sperly/pbrain/hardware/enclosure/preview/back-open.png

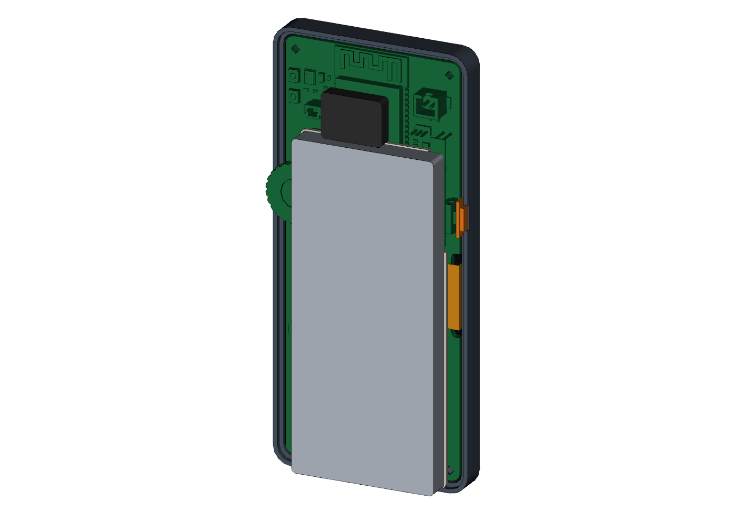
hardware/enclosure/preview/back-open.png
