sperly/pbrain/hardware/enclosure/preview/back.png

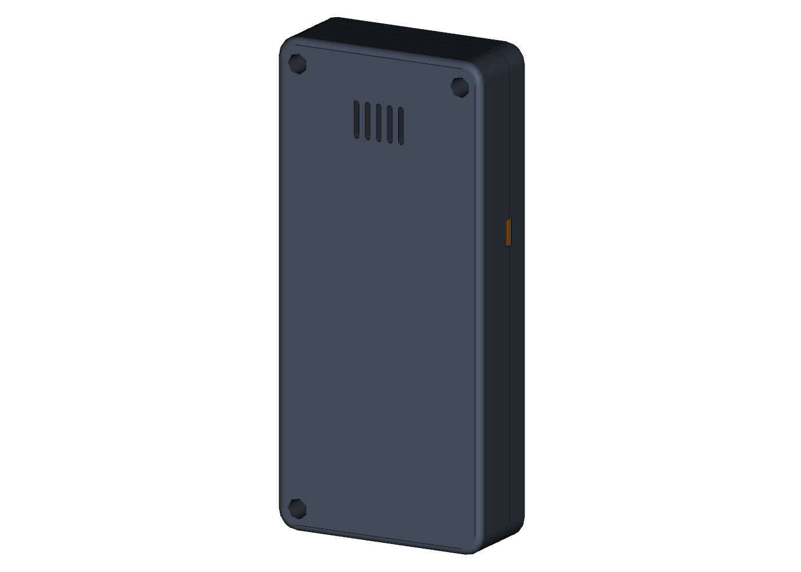
hardware/enclosure/preview/back.png
