sperly/pbrain/hardware/enclosure/preview/exploded.png

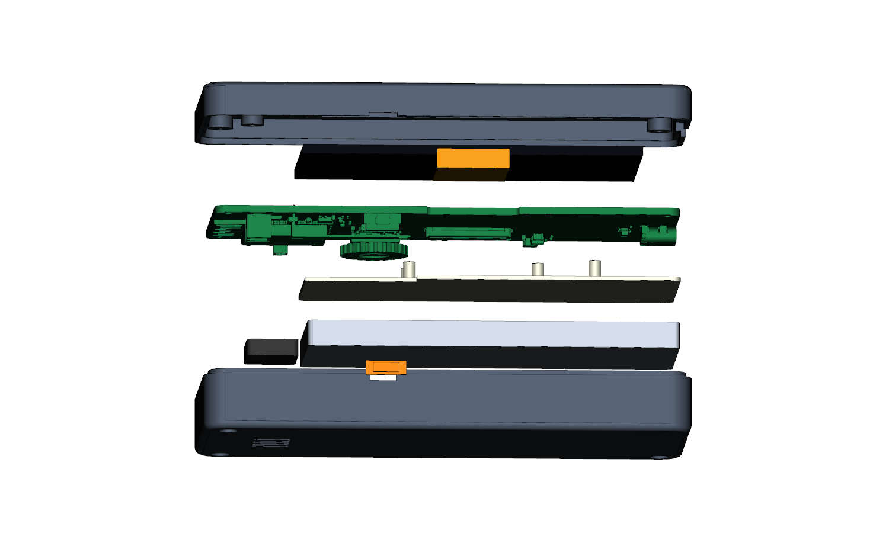
hardware/enclosure/preview/exploded.png
