sperly/pbrain/hardware/enclosure/pocketbrain-assembly.step

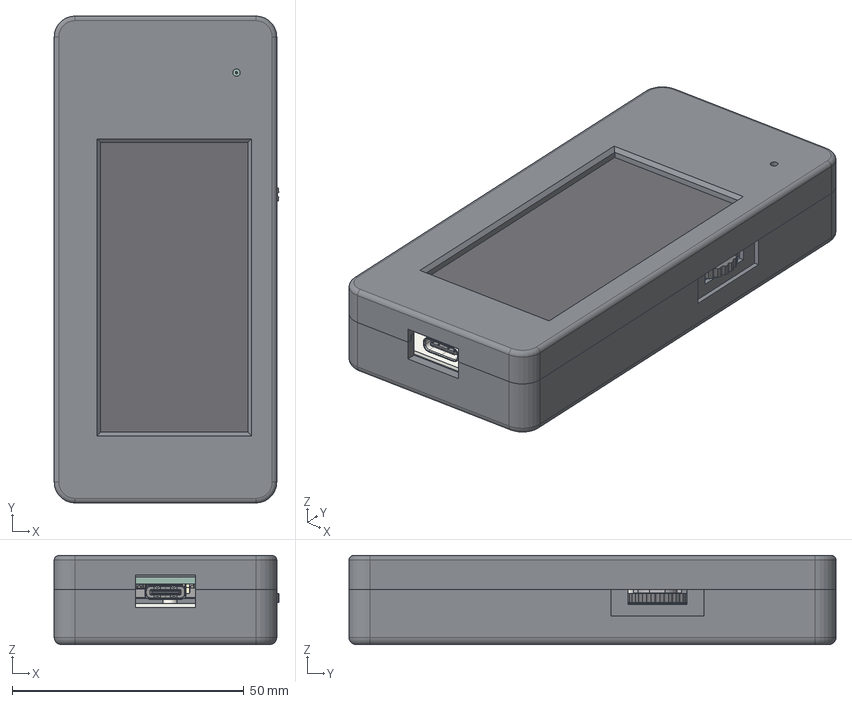
[picture p4: CAD file, 2026-11-11]
hardware/enclosure/pocketbrain-assembly.step
48.4 x 105.0 x 19.2 mm
C_0402_1005Metric x 12
C_0603_1608Metric x 7
Knowles_SPH0645LM4H-6_3.5x2.65mm
R_0402_1005Metric x 24
pads x 3
SW_SPST_B3U-1000P x 2
USB_C_Receptacle_16P_TopMnt_Horizontal_GCT_USB4105-xx-A
housing
pin0
tail0
pin1
tail1
tab0
tab1
ESP32-S3-WROOM-1
C_0805_2012Metric x 6
D_SOD-323 x 2
SOT-23-6 x 2
base
dial
hub
boss0
boss1
term0 x 2
term1 x 2
term2
term3
cover
actuator
leg0
peg0
leg1
peg1
core x 2
t0 x 2
t1 x 2
LED_0603_1608Metric
PinHeader_1x03_P127mm_Vertical
lead0
lead1
film
sensor
JST_SH_BM02B-SRSS-TB_1x02-1MP_P1.00mm_Vertical
lock
pins
pocketbrain_PCB
front_shell
back_shell
battery_tray
talk_button
oled_glass
oled_flex
battery
speaker
