sperly/pbrain/hardware/enclosure/battery_tray.step

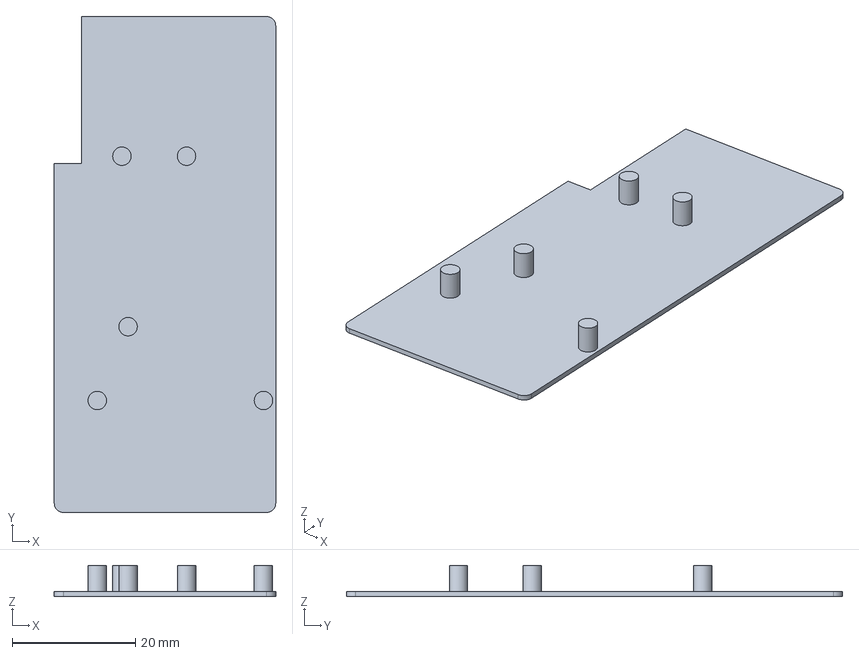
[picture p5: CAD file, 2026-11-11]
hardware/enclosure/battery_tray.step
36.0 x 80.6 x 5.05 mm
