sperly/pbrain/resources/pocketbrain-emboss-18mm.stl

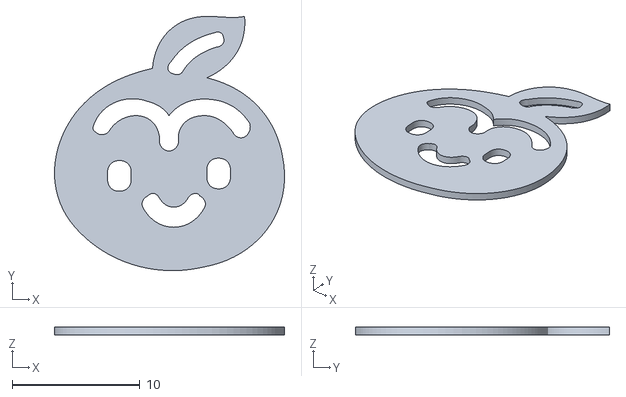
[picture p6: CAD file, 2026-11-11]
resources/pocketbrain-emboss-18mm.stl
18.0 x 19.9 x 0.6
