sperly/pbrain/hardware/enclosure/back_shell.step

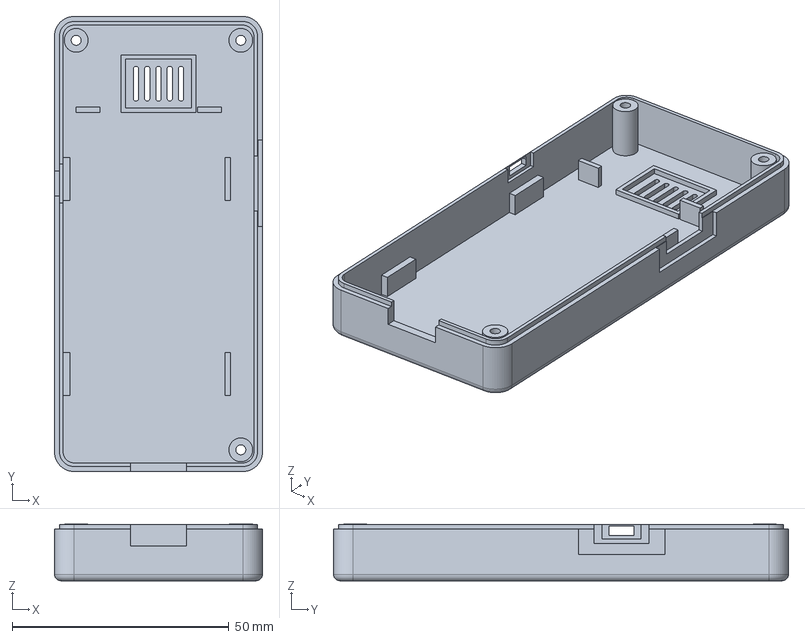
[picture p7: CAD file, 2026-11-11]
hardware/enclosure/back_shell.step
48.0 x 105.0 x 13.0 mm
