sperly/pbrain/hardware/enclosure/front_shell.step

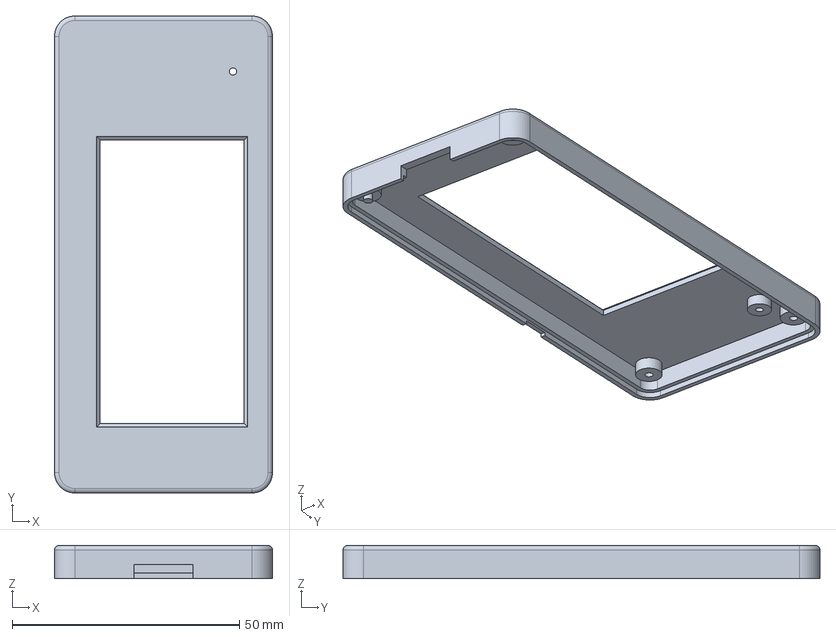
[picture p8: CAD file, 2026-11-11]
hardware/enclosure/front_shell.step
48.0 x 105.0 x 7.30 mm
