sperly/pbrain/hardware/enclosure/talk_button.step

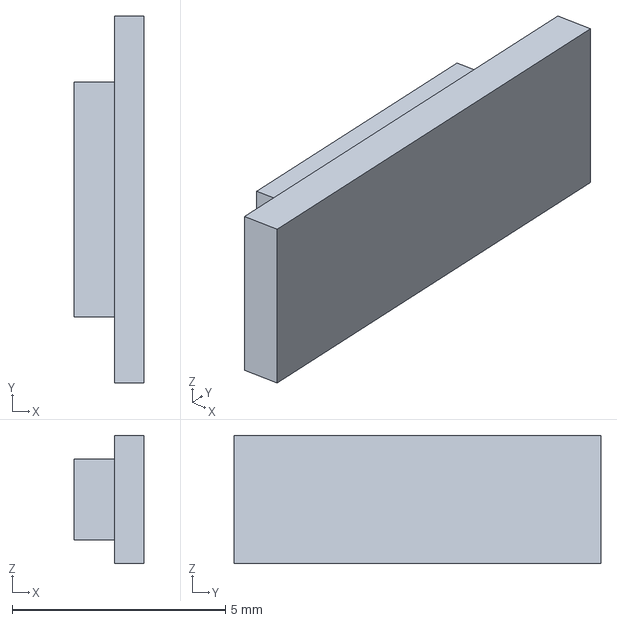
[picture p9: CAD file, 2026-11-11]
hardware/enclosure/talk_button.step
1.65 x 8.60 x 3.00 mm
