sperly/pbrain/(list of files, cad)

Other CAD files:
hardware/enclosure/back_shell.stl
hardware/enclosure/battery_tray.stl
hardware/enclosure/front_shell.stl
hardware/enclosure/talk_button.stl
