sperly/pbrain/hardware/pocketbrain-schematic.pdf

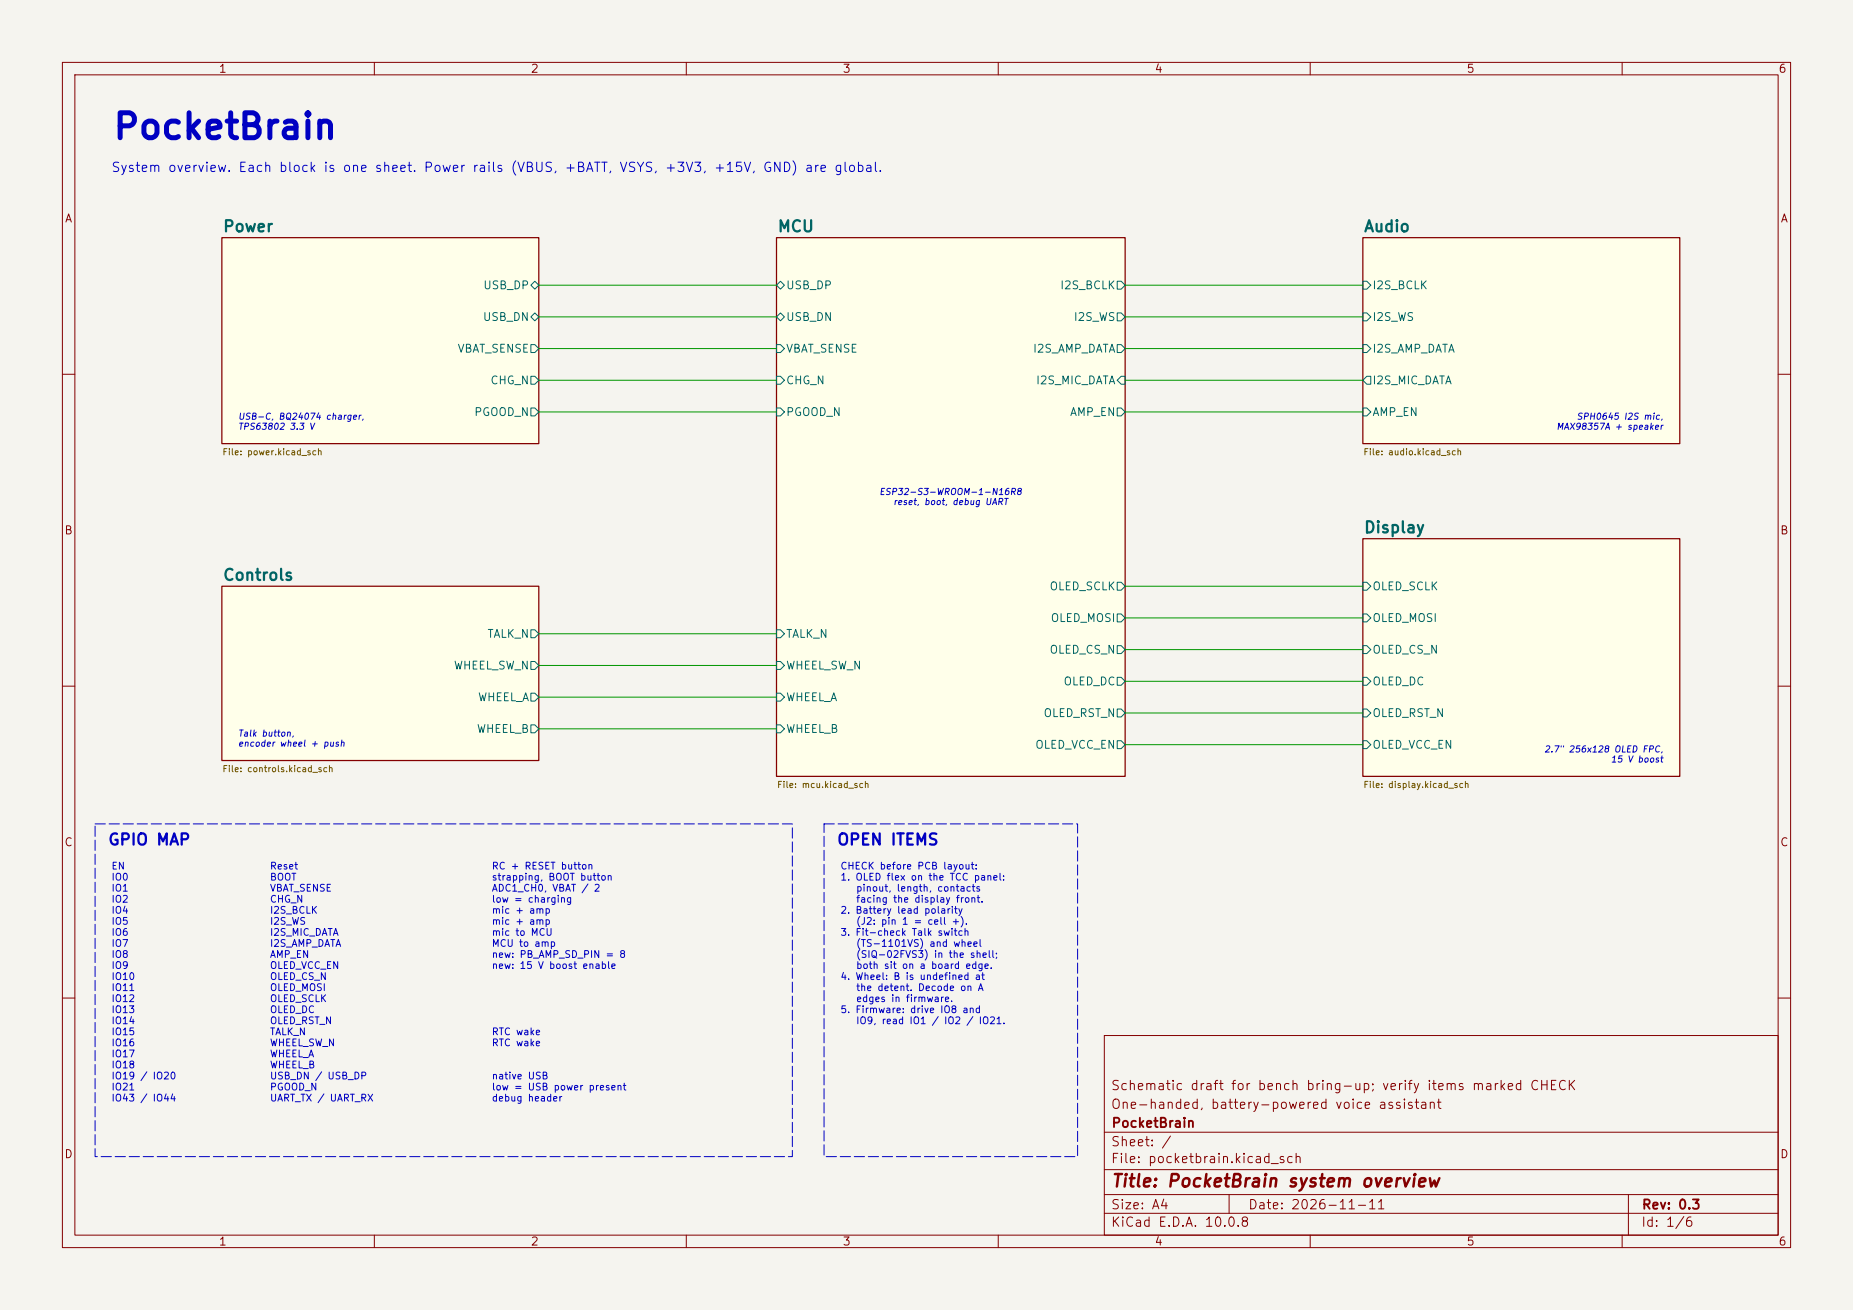
[picture p10: page 1]

System overview. Each block is one sheet. Power rails (VBUS, +BATT, VSYS, +3V3, +15V, GND) are global. USB-C, BQ24074 charger, TPS63802 3.3 V GPIO MAP

ESP32-S3-WROOM-1-N16R8
reset, boot, debug UART

Talk button, encoder wheel + push Reset BOOT VBAT_SENSE CHG_N

2.7" 256x128 OLED FPC, 15 V boost CHECK before PCB layout: 1. OLED flex on the TCC panel:

strapping, BOOT button
ADC1_CH0, VBAT / 2
low = charging mic + amp mic + amp mic to MCU MCU to amp

pinout, length, contacts
facing the display front. 2. Battery lead polarity

(J2: pin 1 = cell +). 3. Fit-check Talk switch

(TS-1101VS) and wheel (SIQ-02FVS3) in the shell; both sit on a board edge. 4. Wheel: B is undefined at

new: PB_AMP_SD_PIN = 8
new: 15 V boost enable RTC wake RTC wake native USB

the detent. Decode on A
edges in firmware. 5. Firmware: drive IO8 and

low = USB power present

Schematic draft for bench bring-up; verify items marked CHECK
One-handed, battery-powered voice assistant
PocketBrain
Sheet: /
File: pocketbrain.kicad_sch
Title: PocketBrain system overview

Size: A4 | Rev: 0.3
KiCad E.D.A. 10.0.8 | Id: 1/6

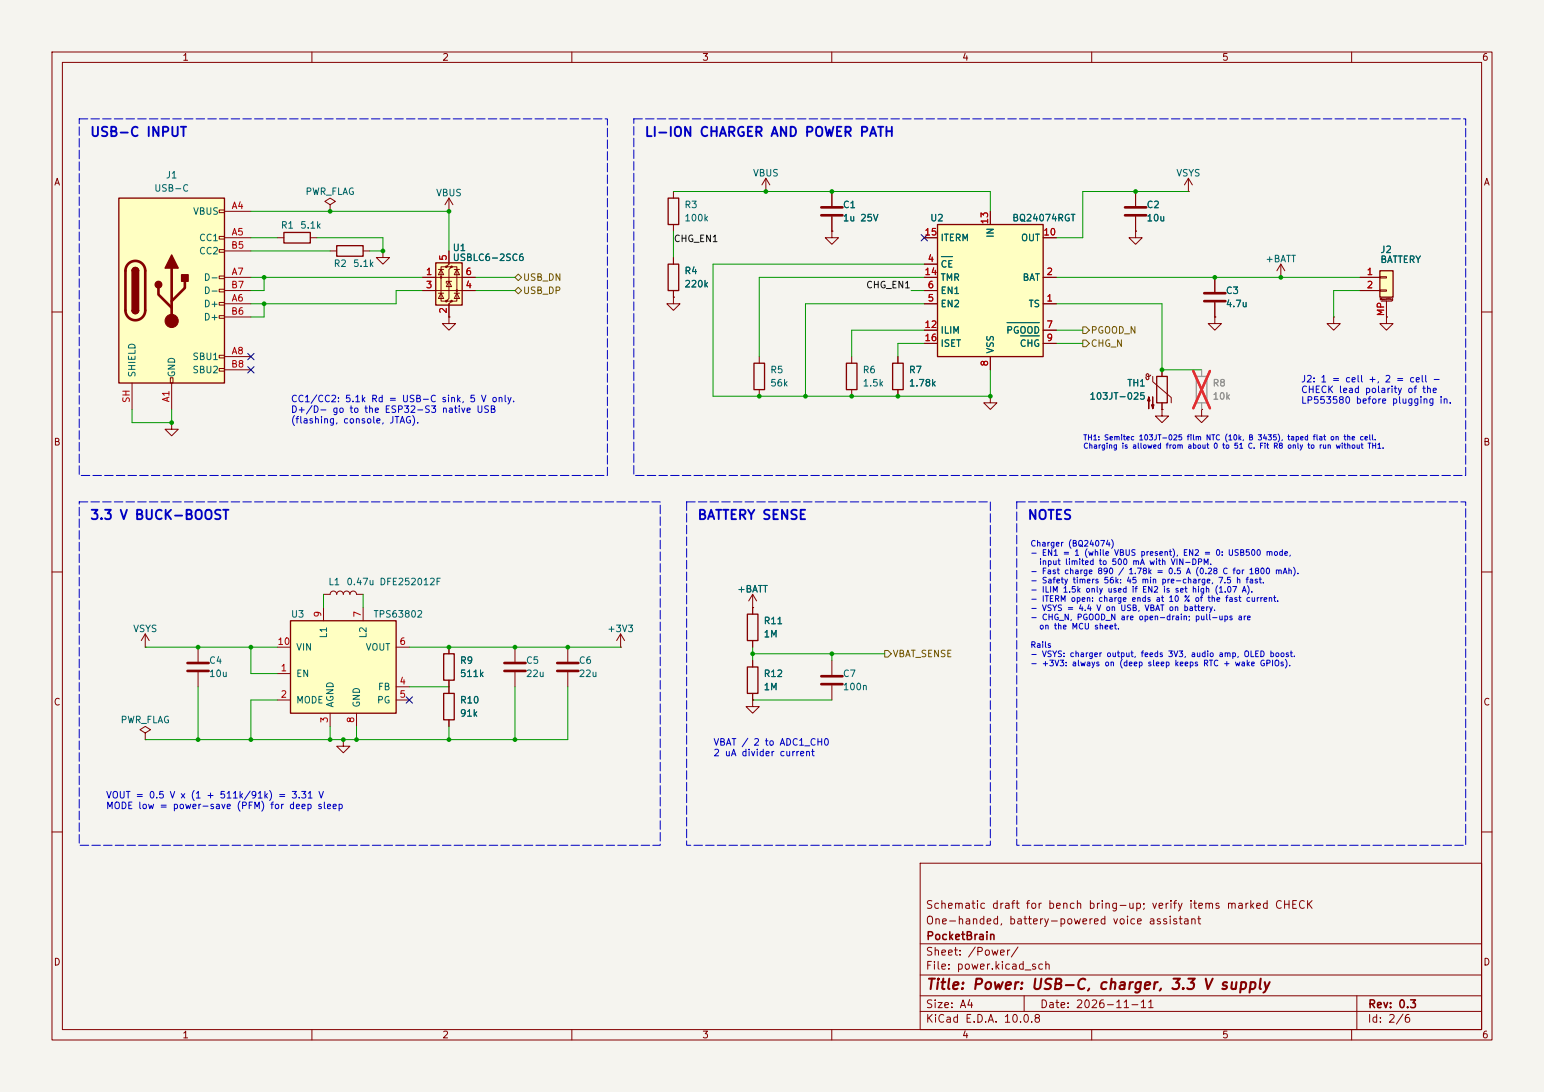
[picture p11: page 2]

J2: 1 = cell +, 2 = cell -
CHECK lead polarity of the

CC1/CC2: 5.1k Rd = USB-C sink, 5 V only.
D+/D- go to the ESP32-S3 native USB
(flashing, console, JTAG).

LP553580 before plugging in. TH1: Semitec 103JT-025 film NTC (10k, B 3435), taped flat on the cell. Charging is allowed from about 0 to 51 C. Fit R8 only to run without TH1. Charger (BQ24074) - EN1 = 1 (while VBUS present), EN2 = 0: USB500 mode,

input limited to 500 mA with VIN-DPM. - Fast charge 890 / 1.78k = 0.5 A (0.28 C for 1800 mAh). - Safety timers 56k: 45 min pre-charge, 7.5 h fast. - ILIM 1.5k only used if EN2 is set high (1.07 A). - ITERM open: charge ends at 10 % of the fast current. - VSYS = 4.4 V on USB, VBAT on battery. - CHG_N, PGOOD_N are open-drain; pull-ups are on the MCU sheet. Rails - VSYS: charger output, feeds 3V3, audio amp, OLED boost. - +3V3: always on (deep sleep keeps RTC + wake GPIOs). VOUT = 0.5 V x (1 + 511k/91k) = 3.31 V MODE low = power-save (PFM) for deep sleep

Schematic draft for bench bring-up; verify items marked CHECK
One-handed, battery-powered voice assistant
PocketBrain
Sheet: /Power/
File: power.kicad_sch
Title: Power: USB-C, charger, 3.3 V supply

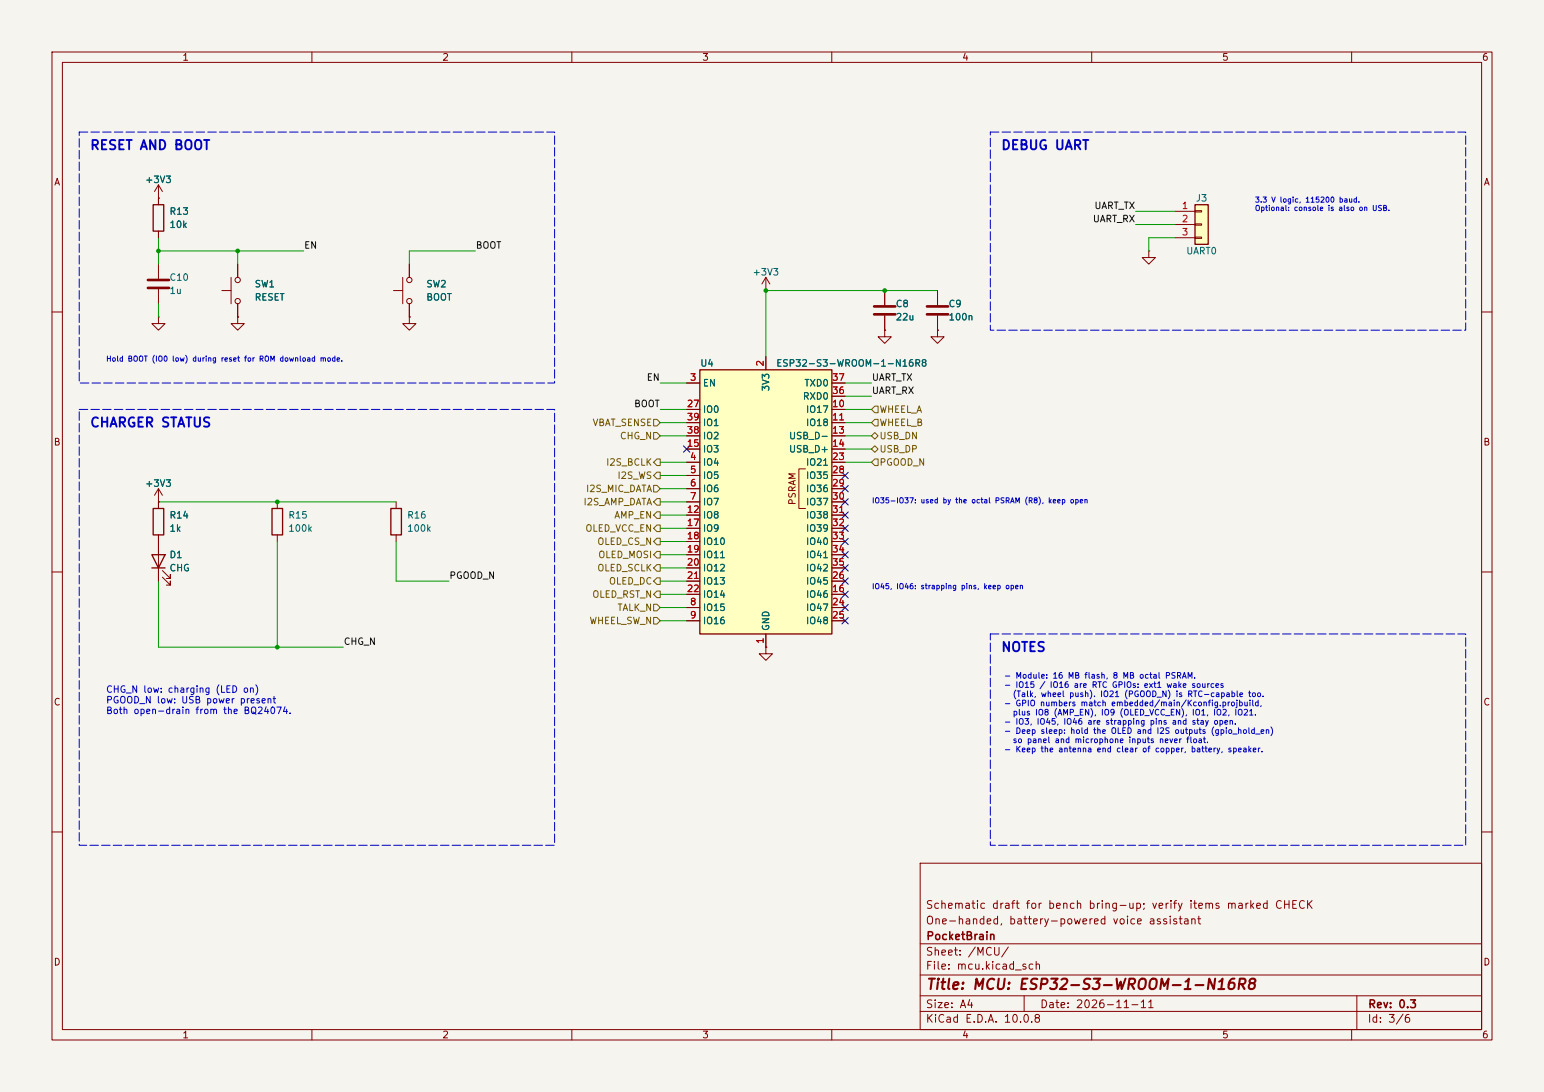
[picture p12: page 3]

3.3 V logic, 115200 baud. Optional: console is also on USB. RESET AND BOOT

Schematic draft for bench bring-up; verify items marked CHECK +3V3 +3V3C10
J3 UART0 R14

BOOT EN CHARGER STATUS

IO45, IO46: strapping pins, keep open NOTES

- Module: 16 MB flash, 8 MB octal PSRAM. - IO15 / IO16 are RTC GPIOs: ext1 wake sources

plus IO8 (AMP_EN), IO9 (OLED_VCC_EN), IO1, IO2, IO21. - IO3, IO45, IO46 are strapping pins and stay open. - Deep sleep: hold the OLED and I2S outputs (gpio_hold_en) so panel and microphone inputs never float. - Keep the antenna end clear of copper, battery, speaker. CHG_N low: charging (LED on) PGOOD_N low: USB power present Both open-drain from the BQ24074.

(Talk, wheel push). IO21 (PGOOD_N) is RTC-capable too. - GPIO numbers match embedded/main/Kconfig.projbuild,

One-handed, battery-powered voice assistant
PocketBrain
Sheet: /MCU/
File: mcu.kicad_sch
Title: MCU: ESP32-S3-WROOM-1-N16R8

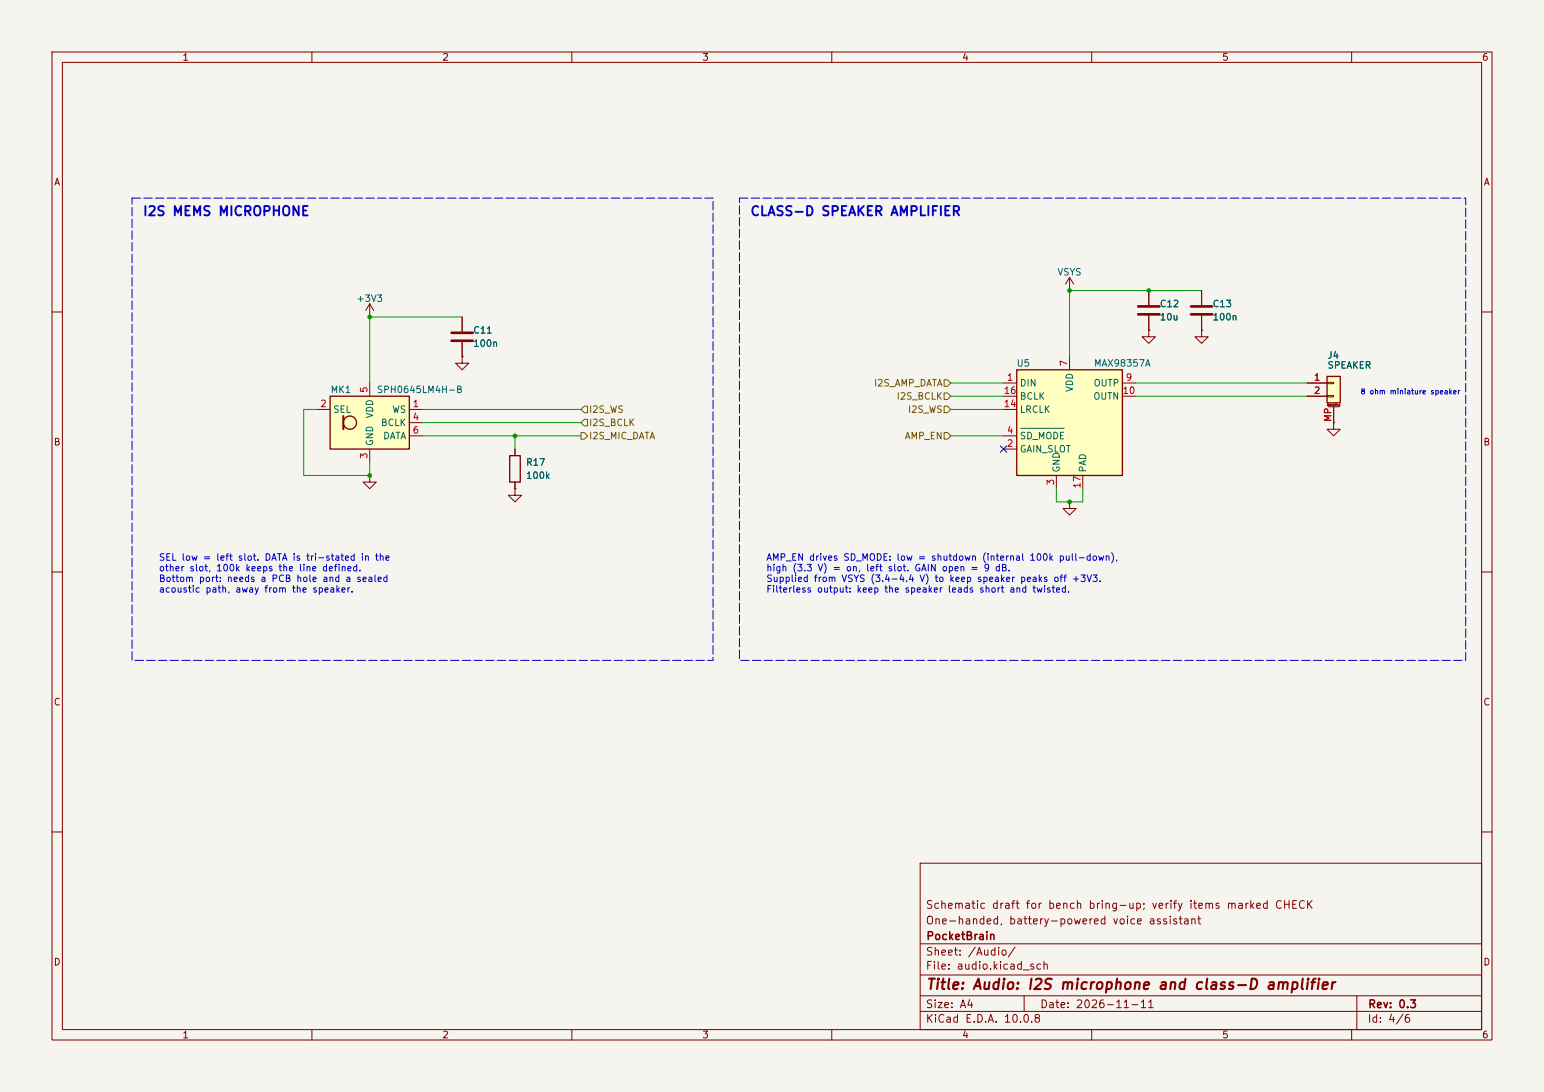
[picture p13: page 4]

8 ohm miniature speaker I2S MEMS MICROPHONE

high (3.3 V) = on, left slot. GAIN open = 9 dB. Supplied from VSYS (3.4-4.4 V) to keep speaker peaks off +3V3. Filterless output: keep the speaker leads short and twisted. C11

SEL low = left slot. DATA is tri-stated in the other slot, 100k keeps the line defined. Bottom port: needs a PCB hole and a sealed

AMP_EN drives SD_MODE: low = shutdown (internal 100k pull-down),

acoustic path, away from the speaker.

Schematic draft for bench bring-up; verify items marked CHECK
One-handed, battery-powered voice assistant
PocketBrain
Sheet: /Audio/
File: audio.kicad_sch
Title: Audio: I2S microphone and class-D amplifier

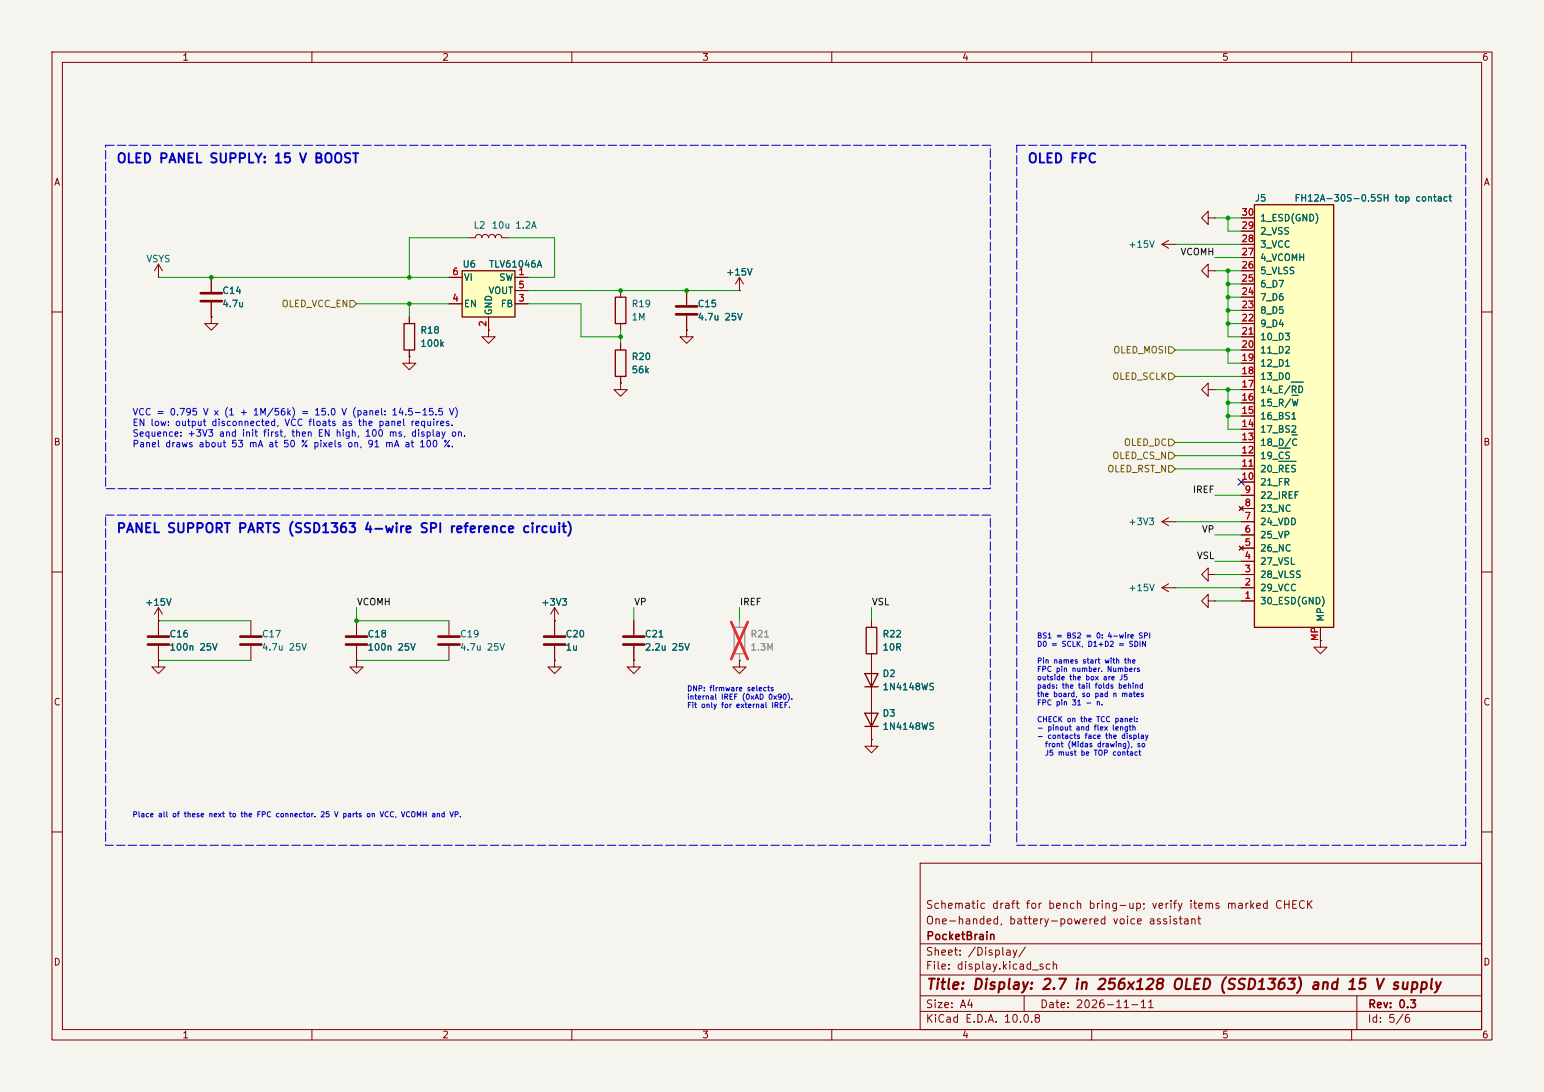
[picture p14: page 5]

VCC = 0.795 V x (1 + 1M/56k) = 15.0 V (panel: 14.5-15.5 V) EN low: output disconnected, VCC floats as the panel requires.

J5 must be TOP contact PANEL SUPPORT PARTS (SSD1363 4-wire SPI reference circuit)

Pin names start with the
FPC pin number. Numbers outside the box are J5

pads: the tail folds behind
the board, so pad n mates FPC pin 31 - n. CHECK on the TCC panel: - pinout and flex length - contacts face the display

front (Midas drawing), so

Schematic draft for bench bring-up; verify items marked CHECK
One-handed, battery-powered voice assistant
PocketBrain
Sheet: /Display/
File: display.kicad_sch
Title: Display: 2.7 in 256x128 OLED (SSD1363) and 15 V supply

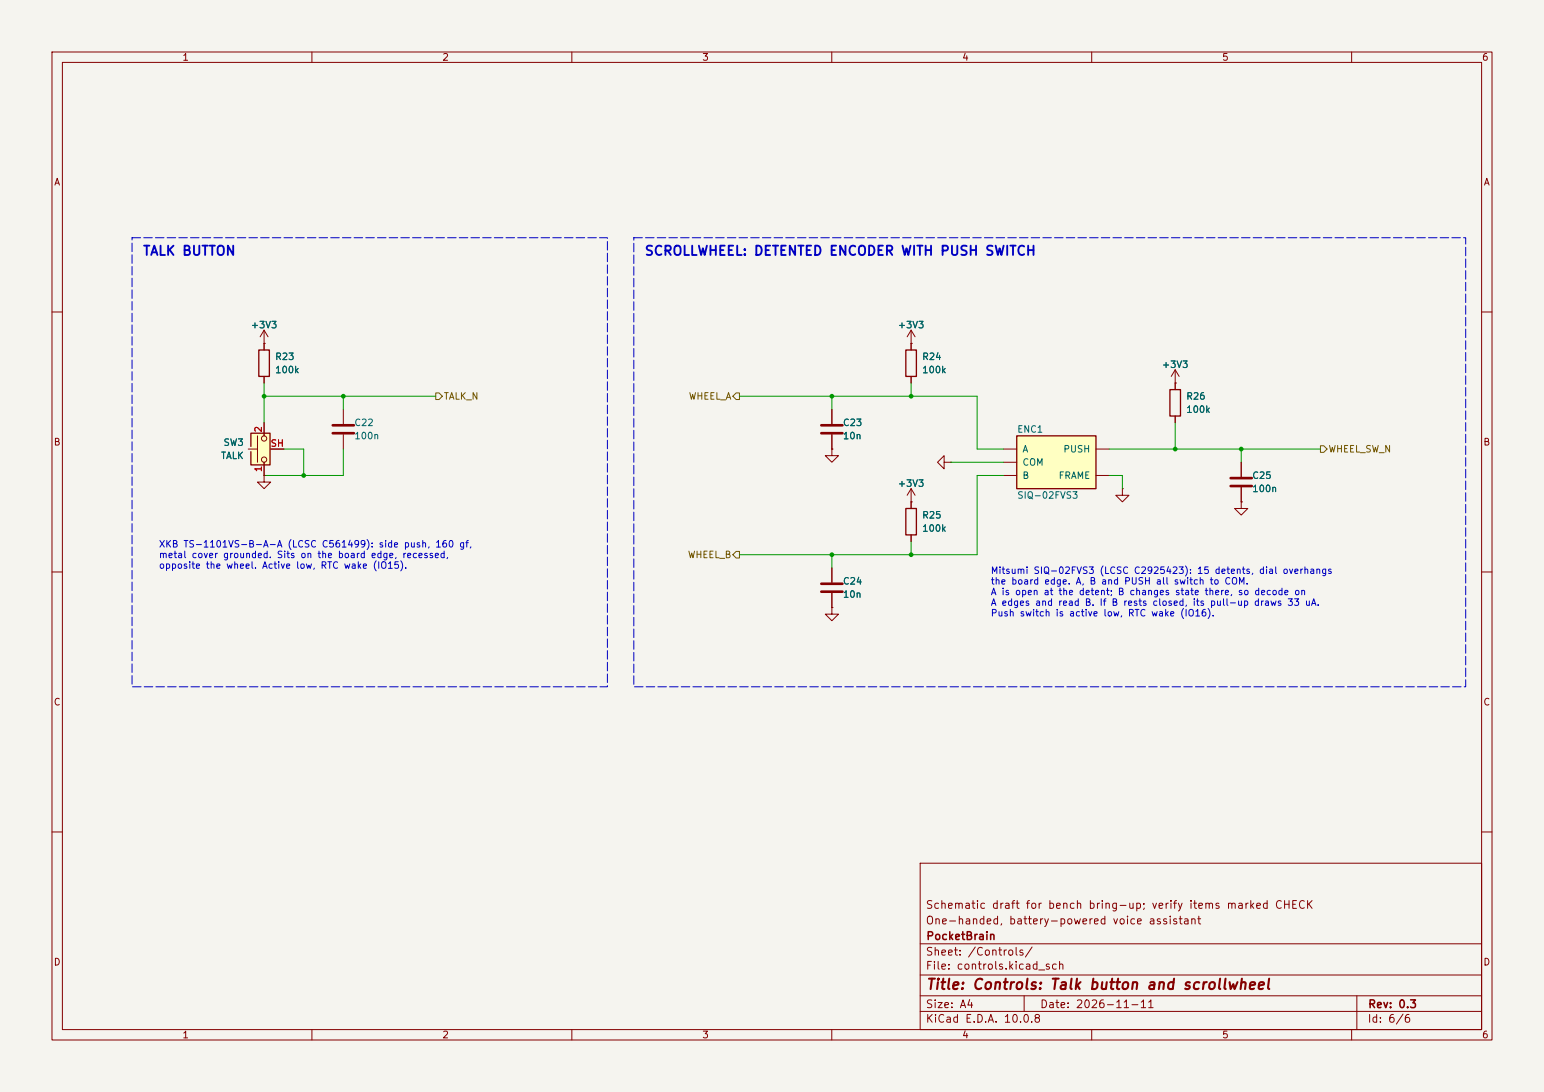
[picture p15: page 6]

opposite the wheel. Active low, RTC wake (IO15). R23

XKB TS-1101VS-B-A-A (LCSC C561499): side push, 160 gf, metal cover grounded. Sits on the board edge, recessed,

Mitsumi SIQ-02FVS3 (LCSC C2925423): 15 detents, dial overhangs
the board edge. A, B and PUSH all switch to COM. A is open at the detent; B changes state there, so decode on

A edges and read B. If B rests closed, its pull-up draws 33 uA. Push switch is active low, RTC wake (IO16).

Schematic draft for bench bring-up; verify items marked CHECK
One-handed, battery-powered voice assistant
PocketBrain
Sheet: /Controls/
File: controls.kicad_sch
Title: Controls: Talk button and scrollwheel
