sperly/pbrain/hardware/pocketbrain.kicad_pcb

## KiCad design hardware/pocketbrain.kicad_pcb (2026-11-11)

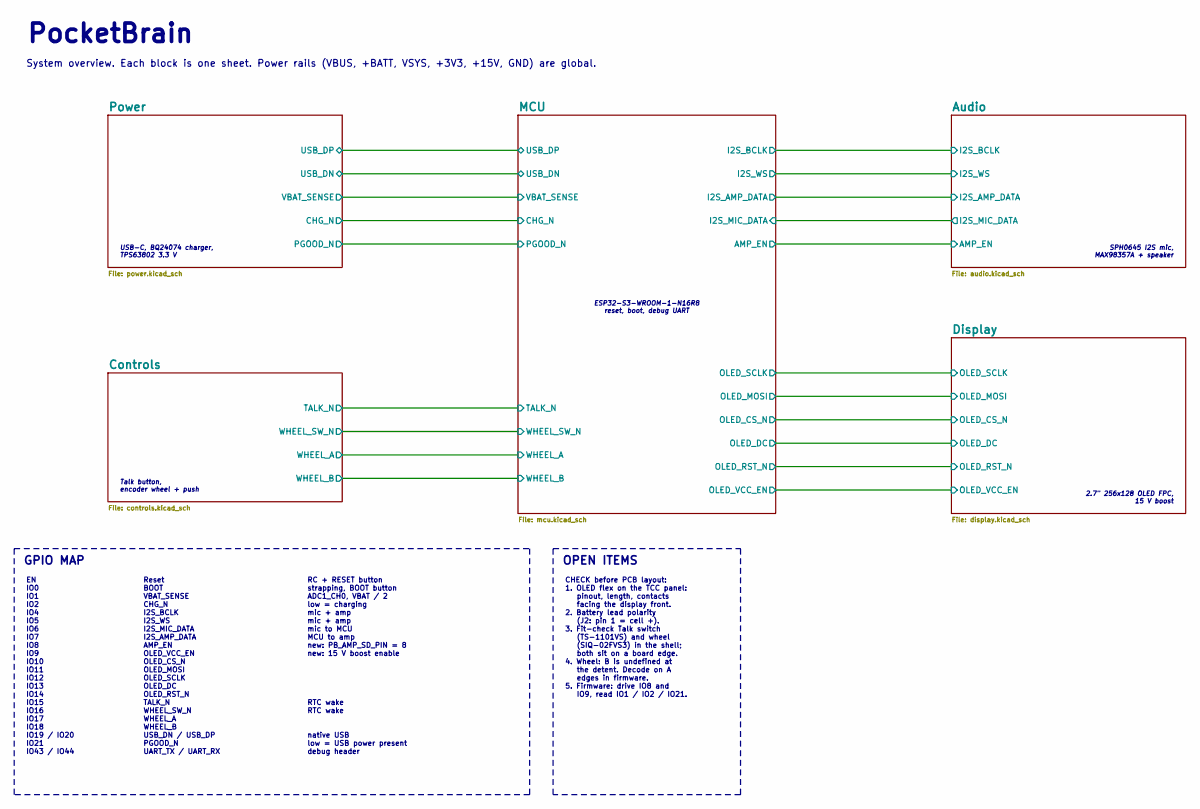
[picture p16: schematic pocketbrain.kicad_sch, PocketBrain system overview]

Notes on the sheet:
USB-C, BQ24074 charger, TPS63802 3.3 V
ESP32-S3-WROOM-1-N16R8 reset, boot, debug UART
CHECK before PCB layout: 1. OLED flex on the TCC panel: pinout, length, contacts facing the display front. 2. Battery lead polarity (J2: pin 1 = cell +). 3. Fit-check Talk switch (TS-1101VS) and wheel (SIQ-02FVS3) in the shell; both sit on a board edge. 4. Wheel: B is undefined at the detent. Decod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
Reset BOOT VBAT_SENSE CHG_N I2S_BCLK I2S_WS I2S_MIC_DATA I2S_AMP_DATA AMP_EN OLED_VCC_EN OLED_CS_N OLED_MOSI OLED_SCLK OLED_DC OLED_RST_N TALK_N WHEEL_SW_N WHEEL_A WHEEL_B USB_DN / USB_DP PGOOD_N UART_TX / UART_RX
Talk button, encoder wheel + push
RC + RESET button strapping, BOOT button ADC1_CH0, VBAT / 2 low = charging mic + amp mic + amp mic to MCU MCU to amp new: PB_AMP_SD_PIN = 8 new: 15 V boost enable RTC wake RTC wake native USB low = USB power present debug header
System overview. Each block is one sheet. Power rails (VBUS, +BATT, VSYS, +3V3, +15V, GND) are global.
2.7" 256x128 OLED FPC, 15 V boost
OPEN ITEMS
GPIO MAP
EN IO0 IO1 IO2 IO4 IO5 IO6 IO7 IO8 IO9 IO10 IO11 IO12 IO13 IO14 IO15 IO16 IO17 IO18 IO19 / IO20 IO21 IO43 / IO44
PocketBrain
SPH0645 I2S mic, MAX98357A + speaker

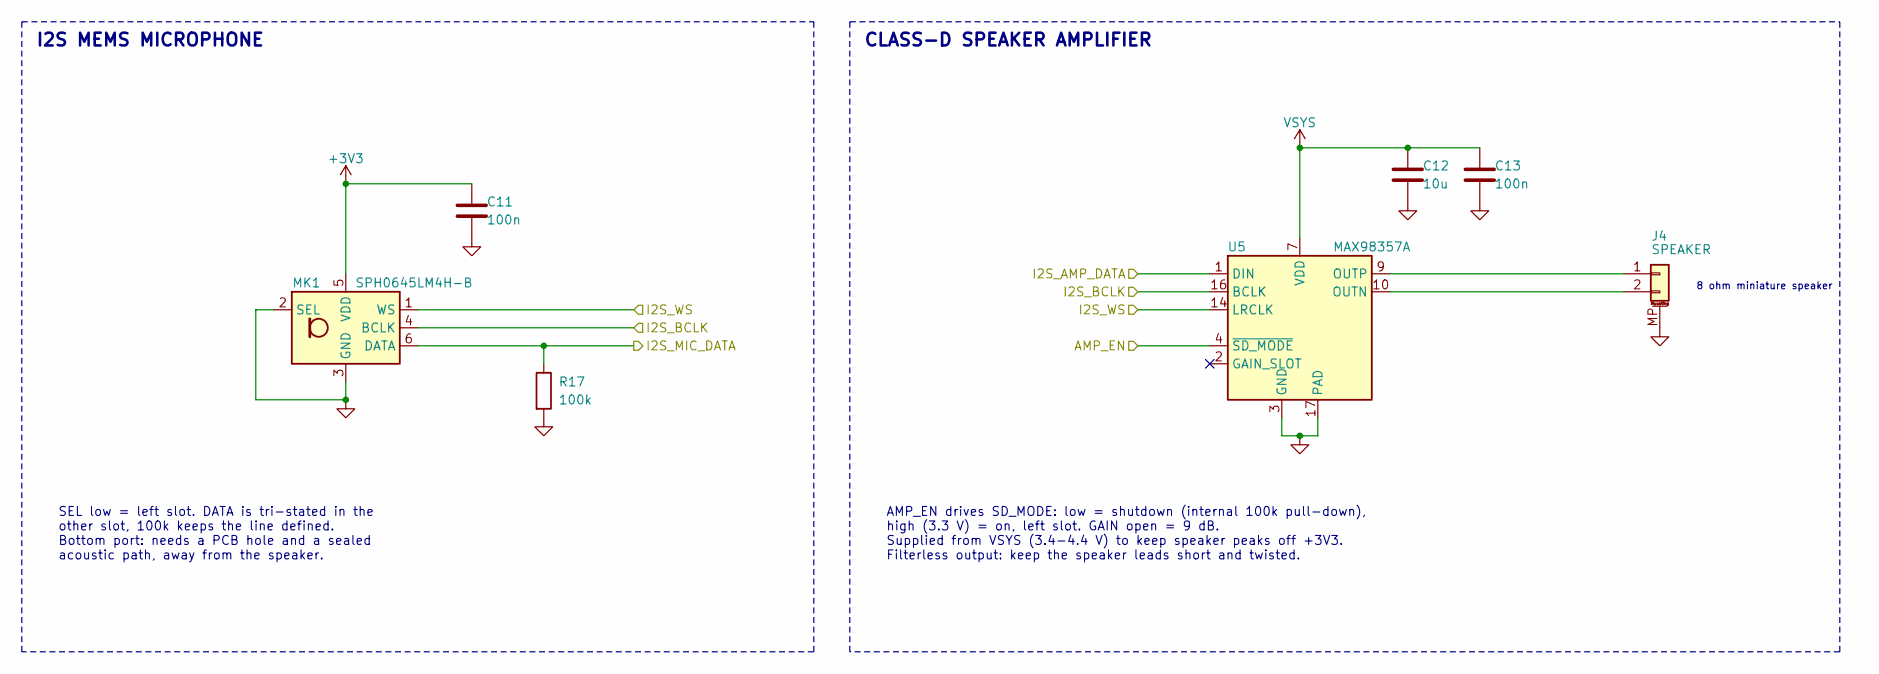
[picture p17: schematic audio.kicad_sch, Audio: I2S microphone and class-D amplifier]

Parts:
C11, C13: 100n; C_0402_1005Metric
C12: 10u; C_0603_1608Metric
J4: SPEAKER; JST_SH_BM02B-SRSS-TB_1x02-1MP_P1.00mm_Vertical
MK1: SPH0645LM4H-B; Knowles_SPH0645LM4H-6_3.5x2.65mm
R17: 100k; R_0402_1005Metric
U5: MAX98357A; TQFN-16-1EP_3x3mm_P0.5mm_EP1.23x1.23mm

Connections:
+3V3: C11.1, MK1.5 (VDD); also elsewhere on the board
/Audio/AMP_EN: U5.4 (~SD_MODE); also elsewhere on the board
/Audio/I2S_AMP_DATA: U5.1 (DIN); also elsewhere on the board
/Audio/I2S_BCLK: MK1.4 (BCLK), U5.16 (BCLK); also elsewhere on the board
/Audio/I2S_MIC_DATA: MK1.6 (DATA), R17.1; also elsewhere on the board
/Audio/I2S_WS: MK1.1 (WS), U5.14 (LRCLK); also elsewhere on the board
GND: C11.2, C12.2, C13.2, J4.MP (MountPin), MK1.2 (SEL), MK1.3 (GND), R17.2, U5.3 (GND), U5.11 (GND), U5.15 (GND), U5.17 (PAD); also elsewhere on the board
unnamed: J4.1, U5.9 (OUTP)
unnamed: J4.2, U5.10 (OUTN)
VSYS: C12.1, C13.1, U5.7 (VDD), U5.8 (VDD); also elsewhere on the board

Notes on the sheet:
CLASS-D SPEAKER AMPLIFIER
AMP_EN drives SD_MODE: low = shutdown (internal 100k pull-down), high (3.3 V) = on, left slot. GAIN open = 9 dB. Supplied from VSYS (3.4-4.4 V) to keep speaker peaks off +3V3. Filterless output: keep the speaker leads short and twisted.
8 ohm miniature speaker
I2S MEMS MICROPHONE
SEL low = left slot. DATA is tri-stated in the other slot, 100k keeps the line defined. Bottom port: needs a PCB hole and a sealed acoustic path, away from the speaker.

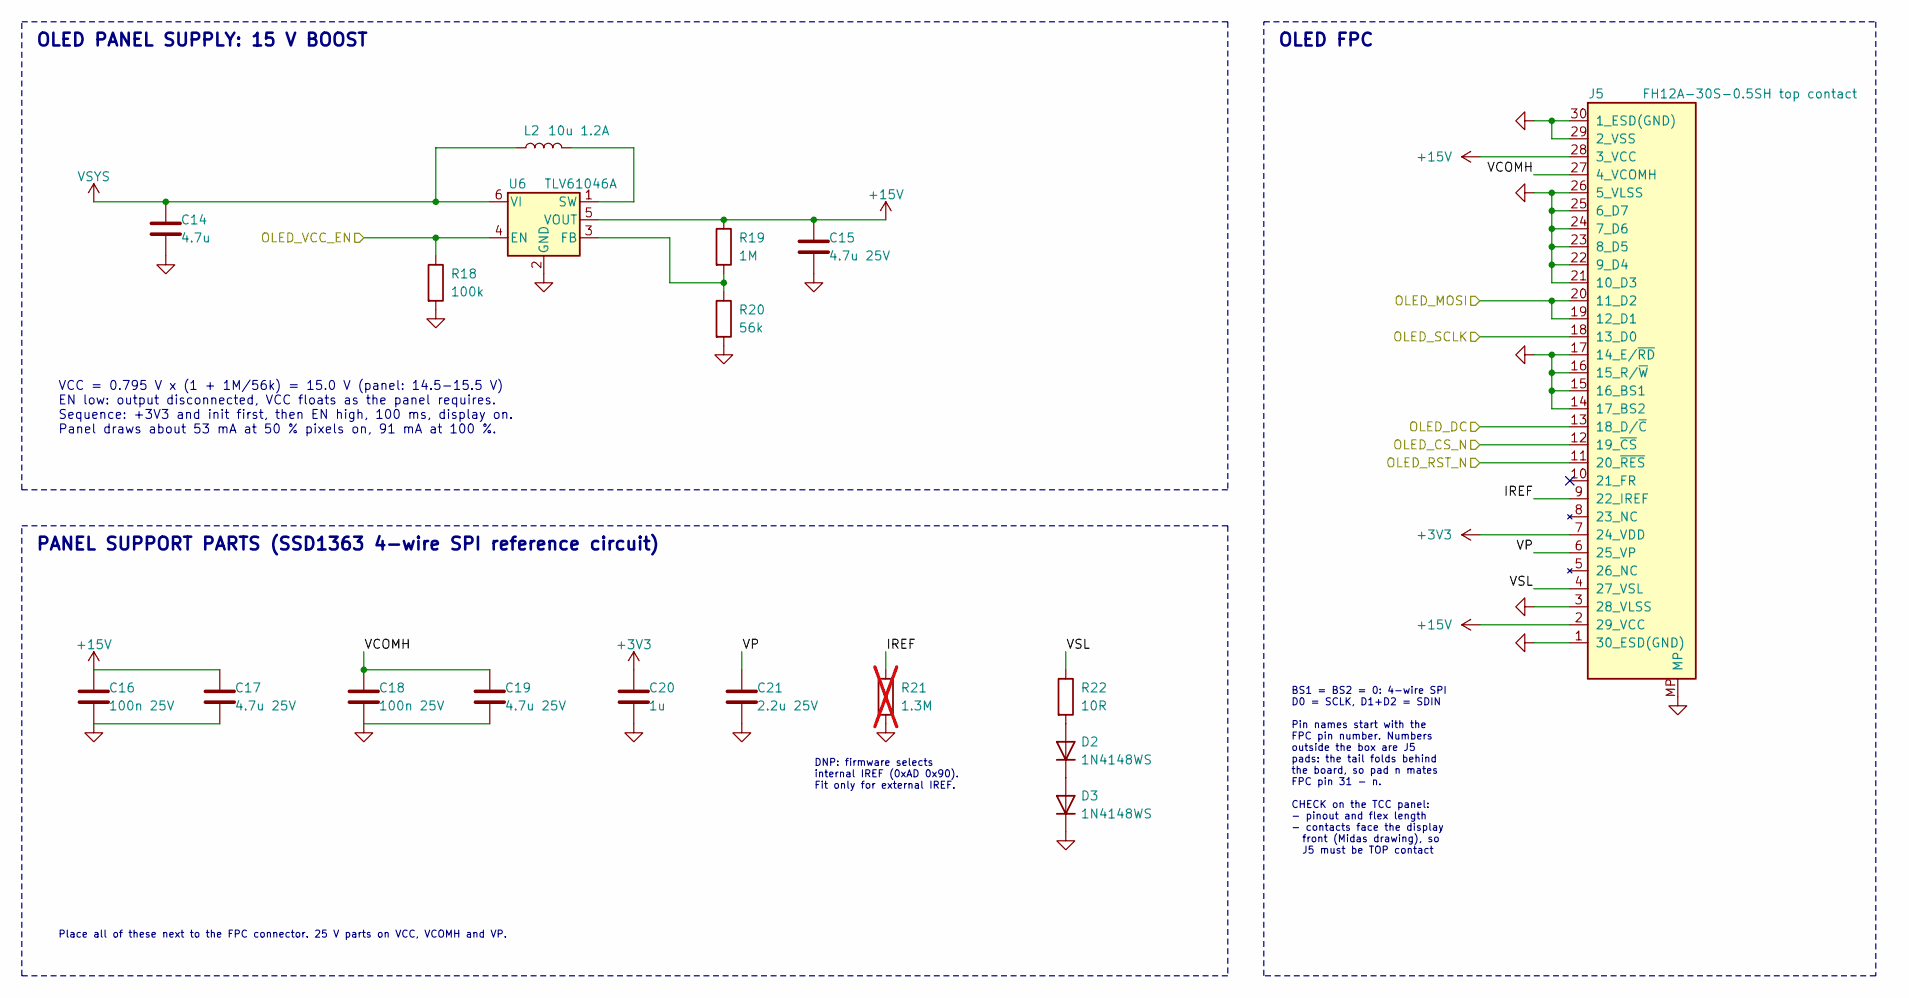
[picture p18: schematic display.kicad_sch, Display: 2.7 in 256x128 OLED (SSD1363) and 15 V supply]

Parts:
C14: 4.7u; C_0603_1608Metric
C15, C17, C19: 4.7u 25V; C_0805_2012Metric
C16, C18: 100n 25V; C_0402_1005Metric
C20: 1u; C_0402_1005Metric
C21: 2.2u 25V; C_0603_1608Metric
D2, D3: 1N4148WS; D_SOD-323
J5: FH12A-30S-0.5SH top contact; Hirose_FH12-30S-0.5SH_1x30-1MP_P0.50mm_Horizontal; MPN FH12A-30S-0.5SH(55); LCSC C3036214
L2: 10u 1.2A; L_Taiyo-Yuden_NR-30xx
R18: 100k; R_0402_1005Metric
R19: 1M; R_0402_1005Metric
R20: 56k; R_0402_1005Metric
R21: 1.3M; R_0402_1005Metric; not fitted
R22: 10R; R_0402_1005Metric
U6: TLV61046A; SOT-23-6

Connections:
+3V3: C20.1, J5.7 (24_VDD); also elsewhere on the board
+15V: C15.1, C16.1, C17.1, J5.2 (29_VCC), J5.28 (3_VCC), R19.1, U6.5 (VOUT)
/Display/IREF: J5.9 (22_IREF), R21.1
/Display/OLED_CS_N: J5.12 (19_~CS); also elsewhere on the board
/Display/OLED_DC: J5.13 (18_D/~C); also elsewhere on the board
/Display/OLED_MOSI: J5.19 (12_D1), J5.20 (11_D2); also elsewhere on the board
/Display/OLED_RST_N: J5.11 (20_~RES); also elsewhere on the board
/Display/OLED_SCLK: J5.18 (13_D0); also elsewhere on the board
/Display/OLED_VCC_EN: R18.1, U6.4 (EN); also elsewhere on the board
/Display/VCOMH: C18.1, C19.1, J5.27 (4_VCOMH)
/Display/VP: C21.1, J5.6 (25_VP)
/Display/VSL: J5.4 (27_VSL), R22.1
GND: C14.2, C15.2, C16.2, C17.2, C18.2, C19.2, C20.2, C21.2, D3.1 (K), J5.1 (30_ESD(GND)), J5.3 (28_VLSS), J5.14 (17_BS2), J5.15 (16_BS1), J5.16 (15_R/~W), J5.17 (14_E/~RD), J5.21 (10_D3), J5.22 (9_D4), J5.23 (8_D5), J5.24 (7_D6), J5.25 (6_D7), J5.26 (5_VLSS), J5.29 (2_VSS), J5.30 (1_ESD(GND)), J5.MP, R18.2, R20.2, R21.2, U6.2 (GND); also elsewhere on the board
unnamed: D2.2 (A), R22.2
unnamed: D2.1 (K), D3.2 (A)
unnamed: R19.2, R20.1, U6.3 (FB)
unnamed: L2.2, U6.1 (SW)
VSYS: C14.1, L2.1, U6.6 (VI); also elsewhere on the board

Notes on the sheet:
PANEL SUPPORT PARTS (SSD1363 4-wire SPI reference circuit)
Place all of these next to the FPC connector. 25 V parts on VCC, VCOMH and VP.
BS1 = BS2 = 0: 4-wire SPI D0 = SCLK, D1+D2 = SDIN Pin names start with the FPC pin number. Numbers outside the box are J5 pads: the tail folds behind the board, so pad n mates FPC pin 31 - n. CHECK on the TCC panel: - pinout and flex length - contacts face the display front (Midas drawing), so J5 m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
VCC = 0.795 V x (1 + 1M/56k) = 15.0 V (panel: 14.5-15.5 V) EN low: output disconnected, VCC floats as the panel requires. Sequence: +3V3 and init first, then EN high, 100 ms, display on. Panel draws about 53 mA at 50 % pixels on, 91 mA at 100 %.
DNP: firmware selects internal IREF (0xAD 0x90). Fit only for external IREF.
OLED PANEL SUPPLY: 15 V BOOST
OLED FPC

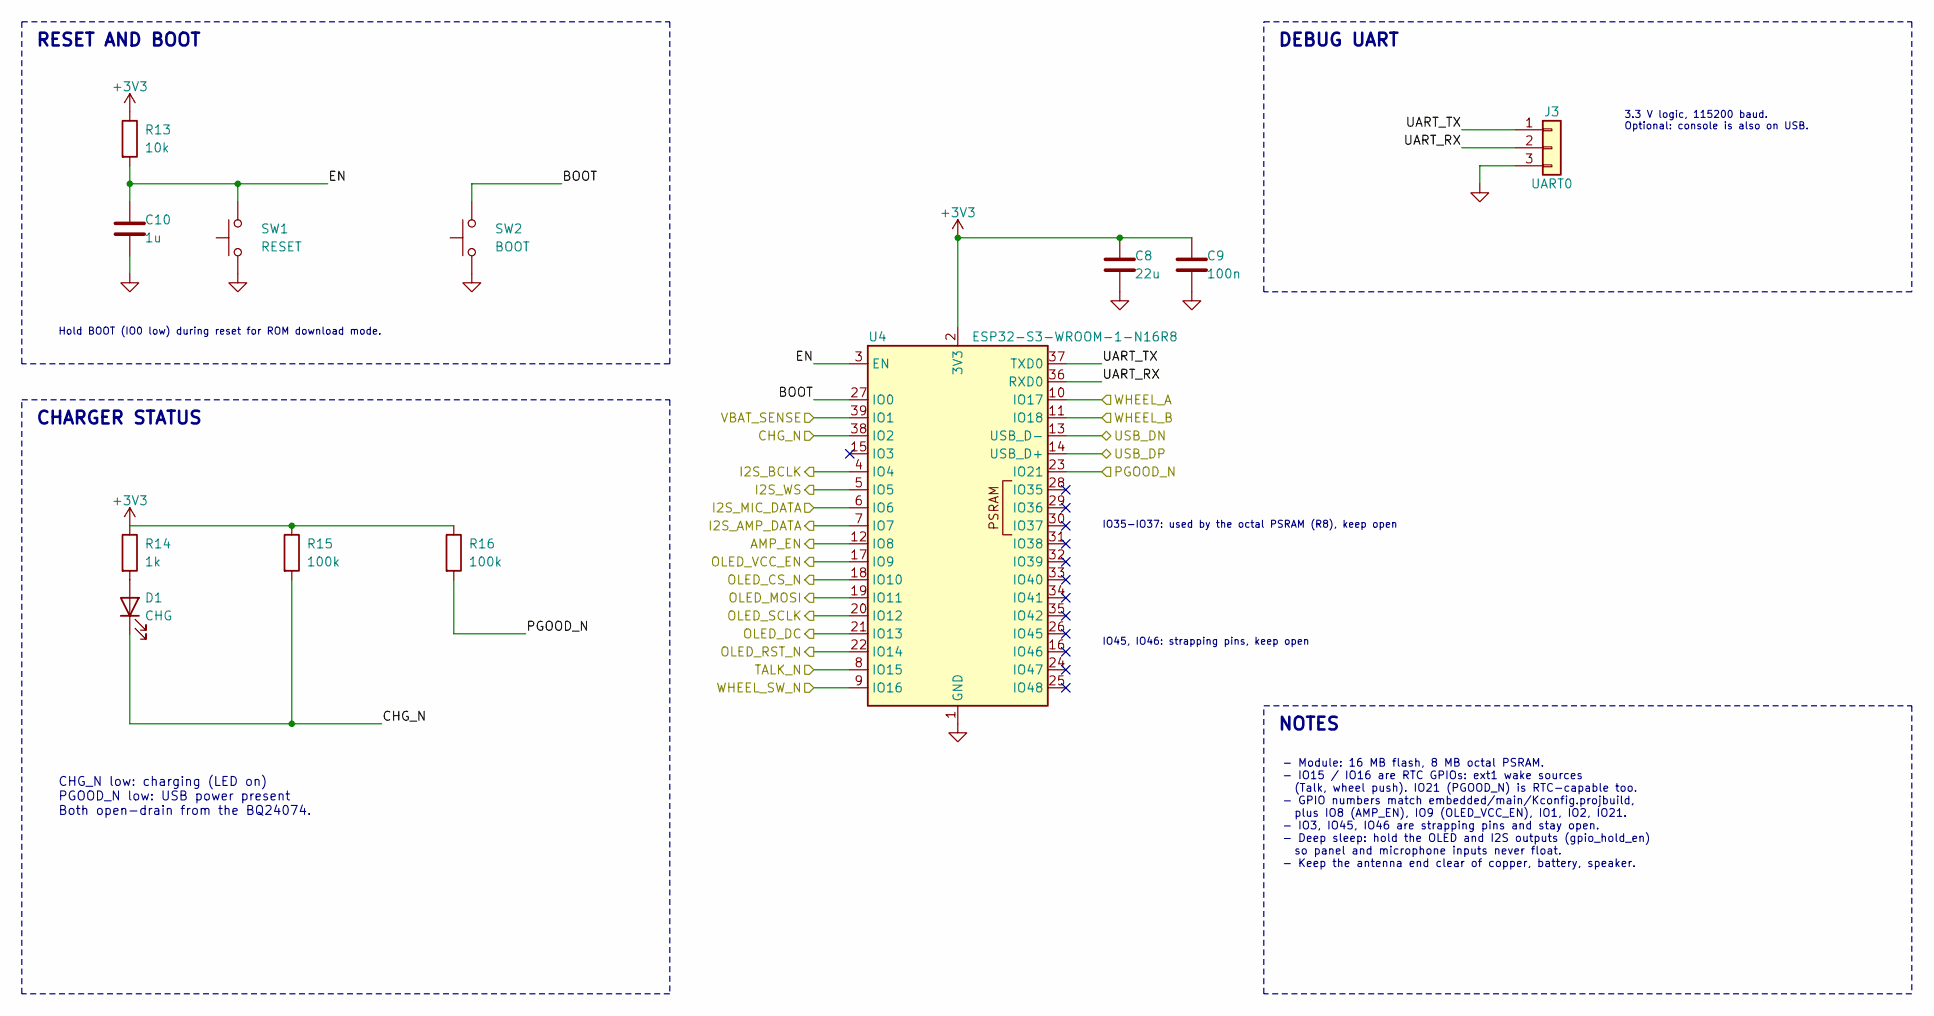
[picture p19: schematic mcu.kicad_sch, MCU: ESP32-S3-WROOM-1-N16R8]

Parts:
C8: 22u; C_0805_2012Metric
C9: 100n; C_0402_1005Metric
C10: 1u; C_0402_1005Metric
D1: CHG; LED_0603_1608Metric
J3: UART0; PinHeader_1x03_P1.27mm_Vertical
R13: 10k; R_0402_1005Metric
R14: 1k; R_0402_1005Metric
R15, R16: 100k; R_0402_1005Metric
SW1: RESET; SW_SPST_B3U-1000P
SW2: BOOT; SW_SPST_B3U-1000P
U4: ESP32-S3-WROOM-1-N16R8; ESP32-S3-WROOM-1

Connections:
+3V3: C8.1, C9.1, R13.1, R14.1, R15.1, R16.1, U4.2 (3V3); also elsewhere on the board
/Audio/AMP_EN: U4.12 (IO8); also elsewhere on the board
/Audio/I2S_AMP_DATA: U4.7 (IO7); also elsewhere on the board
/Audio/I2S_BCLK: U4.4 (IO4); also elsewhere on the board
/Audio/I2S_MIC_DATA: U4.6 (IO6); also elsewhere on the board
/Audio/I2S_WS: U4.5 (IO5); also elsewhere on the board
/Controls/TALK_N: U4.8 (IO15); also elsewhere on the board
/Controls/WHEEL_A: U4.10 (IO17); also elsewhere on the board
/Controls/WHEEL_B: U4.11 (IO18); also elsewhere on the board
/Controls/WHEEL_SW_N: U4.9 (IO16); also elsewhere on the board
/Display/OLED_CS_N: U4.18 (IO10); also elsewhere on the board
/Display/OLED_DC: U4.21 (IO13); also elsewhere on the board
/Display/OLED_MOSI: U4.19 (IO11); also elsewhere on the board
/Display/OLED_RST_N: U4.22 (IO14); also elsewhere on the board
/Display/OLED_SCLK: U4.20 (IO12); also elsewhere on the board
/Display/OLED_VCC_EN: U4.17 (IO9); also elsewhere on the board
/MCU/BOOT: SW2.2, U4.27 (IO0)
/MCU/CHG_N: D1.1 (K), R15.2, U4.38 (IO2); also elsewhere on the board
/MCU/EN: C10.1, R13.2, SW1.2, U4.3 (EN)
/MCU/PGOOD_N: R16.2, U4.23 (IO21); also elsewhere on the board
/MCU/UART_RX: J3.2, U4.36 (RXD0)
/MCU/UART_TX: J3.1, U4.37 (TXD0)
/MCU/USB_DN: U4.13 (USB_D-); also elsewhere on the board
/MCU/USB_DP: U4.14 (USB_D+); also elsewhere on the board
/MCU/VBAT_SENSE: U4.39 (IO1); also elsewhere on the board
GND: C8.2, C9.2, C10.2, J3.3, SW1.1, SW2.1, U4.1 (GND), U4.40 (GND), U4.41 (GND); also elsewhere on the board
unnamed: D1.2 (A), R14.2

Notes on the sheet:
CHARGER STATUS
Hold BOOT (IO0 low) during reset for ROM download mode.
CHG_N low: charging (LED on) PGOOD_N low: USB power present Both open-drain from the BQ24074.
3.3 V logic, 115200 baud. Optional: console is also on USB.
NOTES
RESET AND BOOT
DEBUG UART
IO35-IO37: used by the octal PSRAM (R8), keep open
IO45, IO46: strapping pins, keep open
- Module: 16 MB flash, 8 MB octal PSRAM. - IO15 / IO16 are RTC GPIOs: ext1 wake sources (Talk, wheel push). IO21 (PGOOD_N) is RTC-capable too. - GPIO numbers match embedded/main/Kconfig.projbuild, plus IO8 (AMP_EN), IO9 (OLED_VCC_EN), IO1, IO2, IO21. - IO3, IO45, IO46 are strapping pins and stay op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

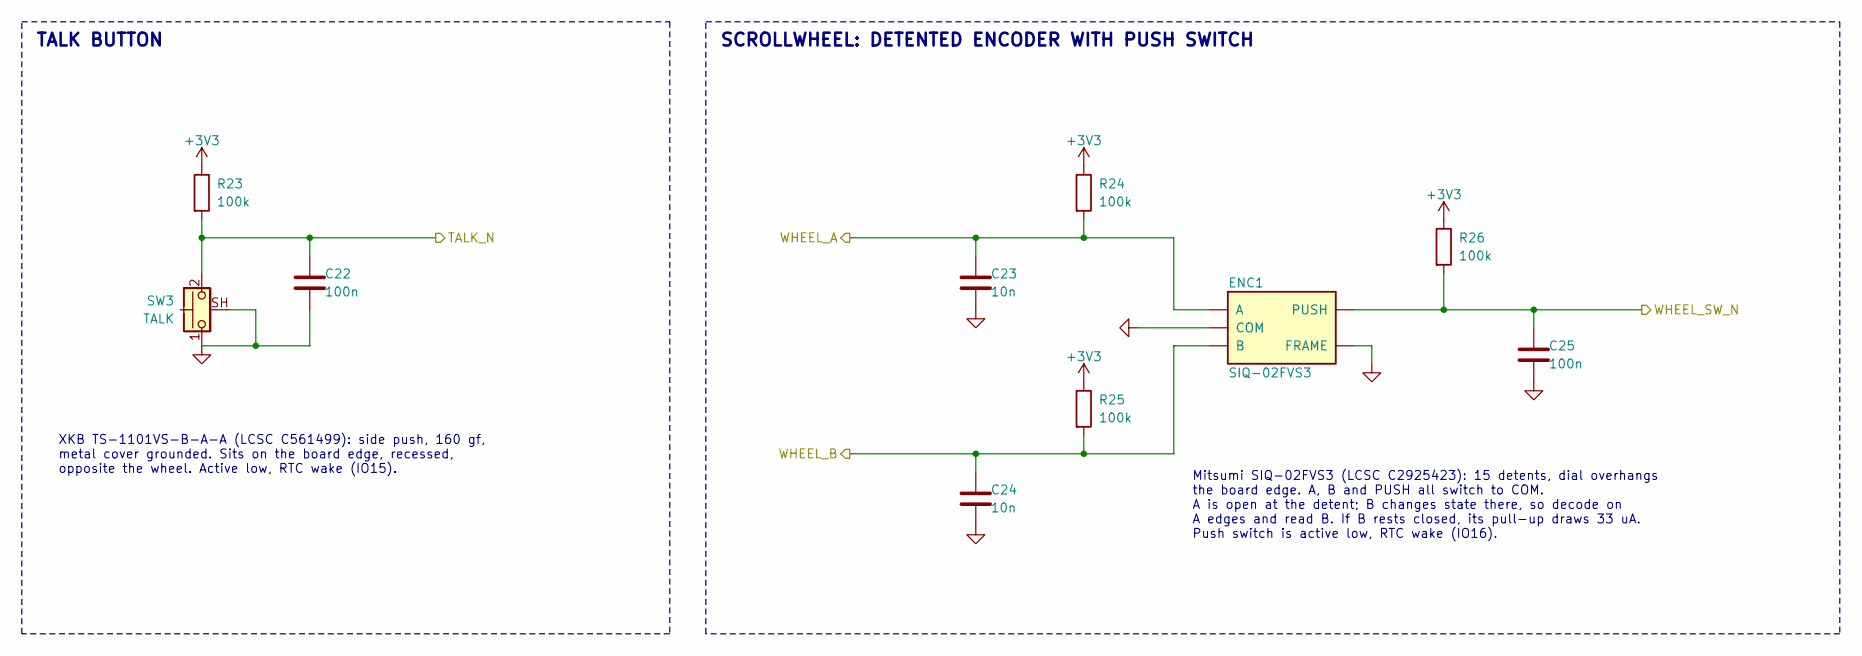
[picture p20: schematic controls.kicad_sch, Controls: Talk button and scrollwheel]

Parts:
C22, C25: 100n; C_0402_1005Metric
C23, C24: 10n; C_0402_1005Metric
ENC1: SIQ-02FVS3; RotaryEncoder_Mitsumi_SIQ-02FVS3; MPN SIQ-02FVS3; LCSC C2925423
R23, R24, R25, R26: 100k; R_0402_1005Metric
SW3: TALK; SW_XKB_TS-1101VS_SidePush; MPN TS-1101VS-B-A-A; LCSC C561499

Connections:
+3V3: R23.1, R24.1, R25.1, R26.1; also elsewhere on the board
/Controls/TALK_N: C22.1, R23.2, SW3.2; also elsewhere on the board
/Controls/WHEEL_A: C23.1, ENC1.A, R24.2; also elsewhere on the board
/Controls/WHEEL_B: C24.1, ENC1.B, R25.2; also elsewhere on the board
/Controls/WHEEL_SW_N: C25.1, ENC1.S (PUSH), R26.2; also elsewhere on the board
GND: C22.2, C23.2, C24.2, C25.2, ENC1.C (COM), ENC1.MP (FRAME), SW3.1, SW3.SH (B); also elsewhere on the board

Notes on the sheet:
SCROLLWHEEL: DETENTED ENCODER WITH PUSH SWITCH
TALK BUTTON
Mitsumi SIQ-02FVS3 (LCSC C2925423): 15 detents, dial overhangs the board edge. A, B and PUSH all switch to COM. A is open at the detent; B changes state there, so decode on A edges and read B. If B rests closed, its pull-up draws 33 uA. Push switch is active low, RTC wake (IO16).
XKB TS-1101VS-B-A-A (LCSC C561499): side push, 160 gf, metal cover grounded. Sits on the board edge, recessed, opposite the wheel. Active low, RTC wake (IO15).

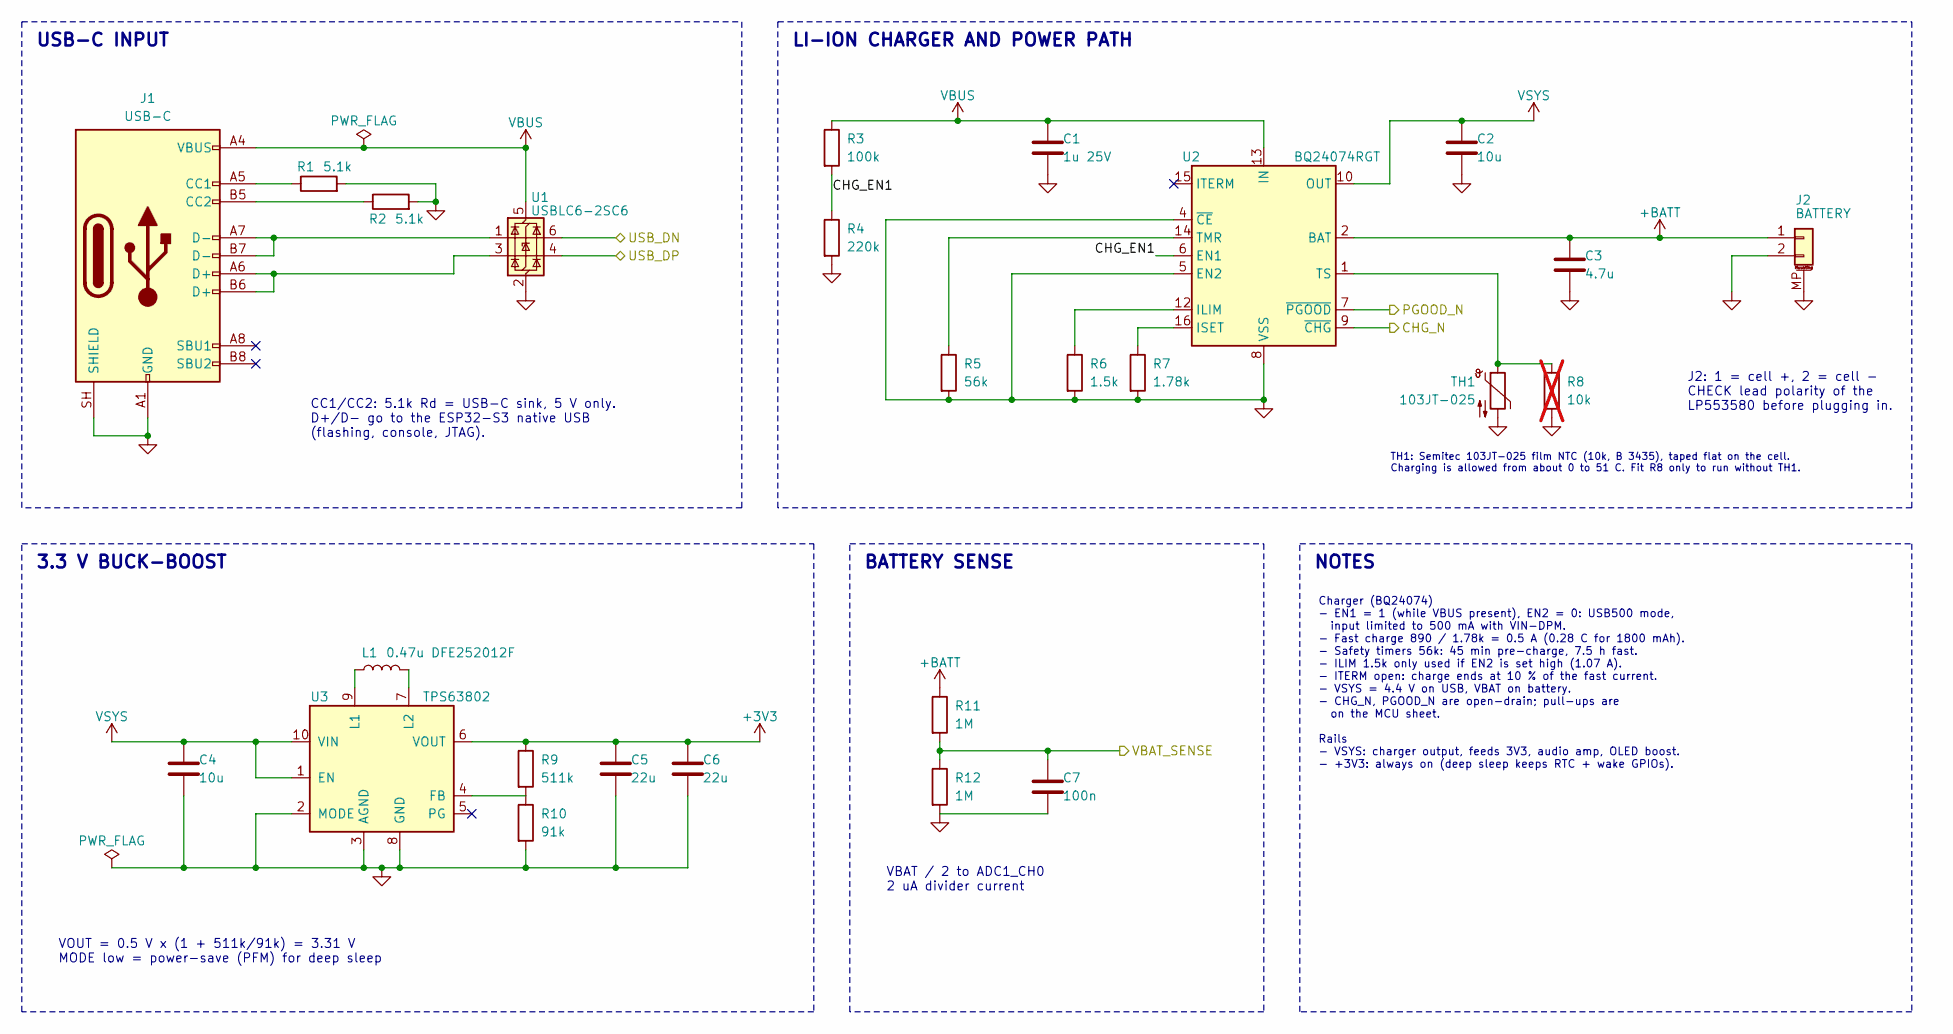
[picture p21: schematic power.kicad_sch, Power: USB-C, charger, 3.3 V supply]

Parts:
C1: 1u 25V; C_0603_1608Metric
C2, C4: 10u; C_0603_1608Metric
C3: 4.7u; C_0603_1608Metric
C5, C6: 22u; C_0805_2012Metric
C7: 100n; C_0402_1005Metric
J1: USB-C; USB_C_Receptacle_GCT_USB4105-xx-A_16P_TopMnt_Horizontal
J2: BATTERY; JST_PH_B2B-PH-SM4-TB_1x02-1MP_P2.00mm_Vertical
L1: 0.47u DFE252012F; L_Murata_DFE252012; MPN DFE252012F-R47M=P2; LCSC C703140
R1, R2: 5.1k; R_0402_1005Metric
R3: 100k; R_0402_1005Metric
R4: 220k; R_0402_1005Metric
R5: 56k; R_0402_1005Metric
R6: 1.5k; R_0402_1005Metric
R7: 1.78k; R_0402_1005Metric
R8: 10k; R_0402_1005Metric; not fitted
R9: 511k; R_0402_1005Metric
R10: 91k; R_0402_1005Metric
R11, R12: 1M; R_0402_1005Metric
TH1: 103JT-025; Thermistor_Semitec_JT_Leads_P1.8mm; MPN 103JT-025
U1: USBLC6-2SC6; SOT-23-6
U2: BQ24074RGT; VQFN-16-1EP_3x3mm_P0.5mm_EP1.6x1.6mm
U3: TPS63802; Texas_DLA0010A_VSON-HR-10_2x3mm_P0.5mm; MPN TPS63802DLAR; LCSC C2845237

Connections:
+3V3: C5.1, C6.1, R9.1, U3.6 (VOUT); also elsewhere on the board
+BATT: C3.1, J2.1, R11.1, U2.2 (BAT), U2.3 (BAT)
/MCU/CHG_N: U2.9 (~CHG); also elsewhere on the board
/MCU/PGOOD_N: U2.7 (~PGOOD); also elsewhere on the board
/MCU/USB_DN: U1.6 (I/O1); also elsewhere on the board
/MCU/USB_DP: U1.4 (I/O2); also elsewhere on the board
/MCU/VBAT_SENSE: C7.1, R11.2, R12.1; also elsewhere on the board
/Power/CHG_EN1: R3.2, R4.1, U2.6 (EN1)
GND: C1.2, C2.2, C3.2, C4.2, C5.2, C6.2, C7.2, J1.A1 (GND), J1.A12 (GND), J1.B1 (GND), J1.B12 (GND), J1.SH (SHIELD), J2.2, J2.MP (MountPin), R1.2, R2.2, R4.2, R5.2, R6.2, R7.2, R8.2, R10.2, R12.2, TH1.2, U1.2 (GND), U2.4 (~CE), U2.5 (EN2), U2.8 (VSS), U2.17 (VSS), U3.2 (MODE), U3.3 (AGND), U3.8 (GND); also elsewhere on the board
unnamed: J1.A5 (CC1), R1.1
unnamed: J1.B5 (CC2), R2.1
unnamed: J1.A6 (D+), J1.B6 (D+), U1.3 (I/O2)
unnamed: J1.A7 (D-), J1.B7 (D-), U1.1 (I/O1)
unnamed: R6.1, U2.12 (ILIM)
unnamed: R7.1, U2.16 (ISET)
unnamed: R5.1, U2.14 (TMR)
unnamed: R8.1, TH1.1, U2.1 (TS)
unnamed: R9.2, R10.1, U3.4 (FB)
unnamed: L1.1, U3.9 (L1)
unnamed: L1.2, U3.7 (L2)
VBUS: C1.1, J1.A4 (VBUS), J1.A9 (VBUS), J1.B4 (VBUS), J1.B9 (VBUS), R3.1, U1.5 (VBUS), U2.13 (IN)
VSYS: C2.1, C4.1, U2.10 (OUT), U2.11 (OUT), U3.1 (EN), U3.10 (VIN); also elsewhere on the board

Notes on the sheet:
J2: 1 = cell +, 2 = cell - CHECK lead polarity of the LP553580 before plugging in.
LI-ION CHARGER AND POWER PATH
3.3 V BUCK-BOOST
VBAT / 2 to ADC1_CH0 2 uA divider current
CC1/CC2: 5.1k Rd = USB-C sink, 5 V only. D+/D- go to the ESP32-S3 native USB (flashing, console, JTAG).
TH1: Semitec 103JT-025 film NTC (10k, B 3435), taped flat on the cell. Charging is allowed from about 0 to 51 C. Fit R8 only to run without TH1.
BATTERY SENSE
USB-C INPUT
Charger (BQ24074) - EN1 = 1 (while VBUS present), EN2 = 0: USB500 mode, input limited to 500 mA with VIN-DPM. - Fast charge 890 / 1.78k = 0.5 A (0.28 C for 1800 mAh). - Safety timers 56k: 45 min pre-charge, 7.5 h fast. - ILIM 1.5k only used if EN2 is set high (1.07 A). - ITERM open: charge ends at 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
NOTES
VOUT = 0.5 V x (1 + 511k/91k) = 3.31 V MODE low = power-save (PFM) for deep sleep

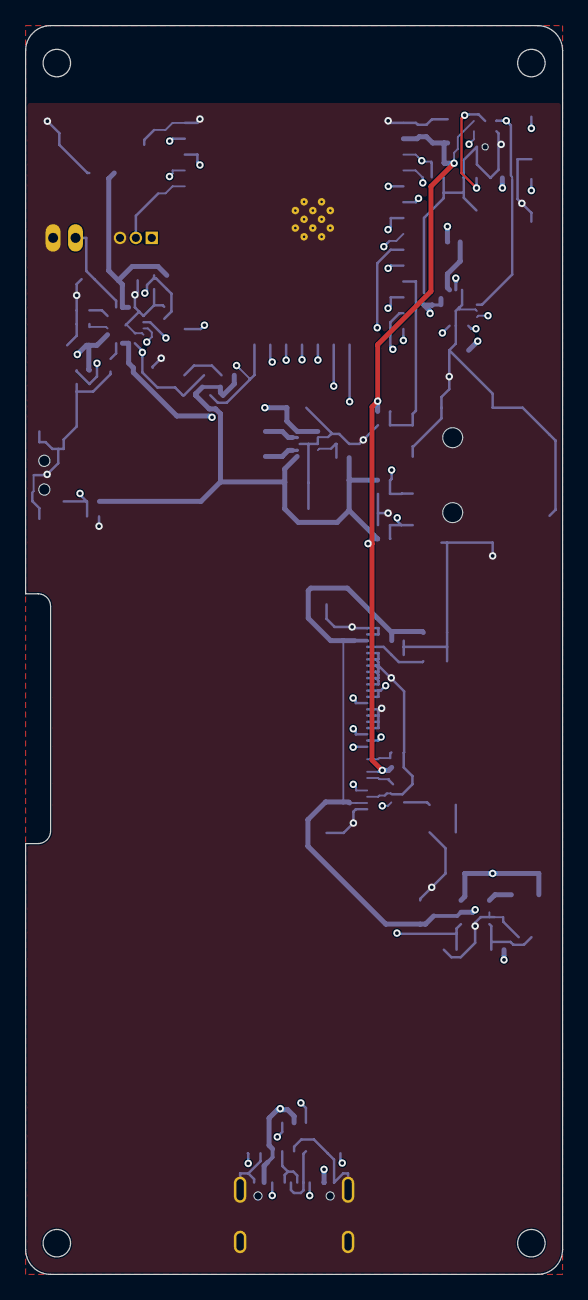
[picture p22: board pocketbrain.kicad_pcb from above]

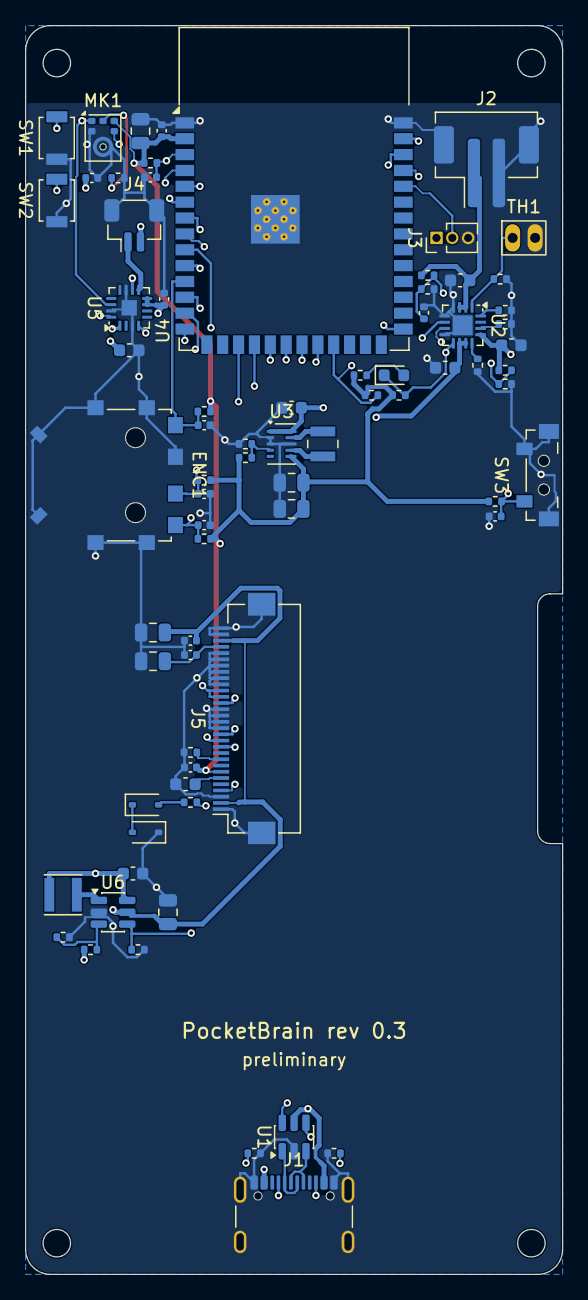
[picture p23: board pocketbrain.kicad_pcb from below]

Board: 4 copper layers, 43.0 x 100.0 mm, 73 parts (73 on the bottom side), 53 nets.
